MattisLind/hp9835_unified_ram_rom_board/requirements/reference_photos/connector_pin_orientation.png

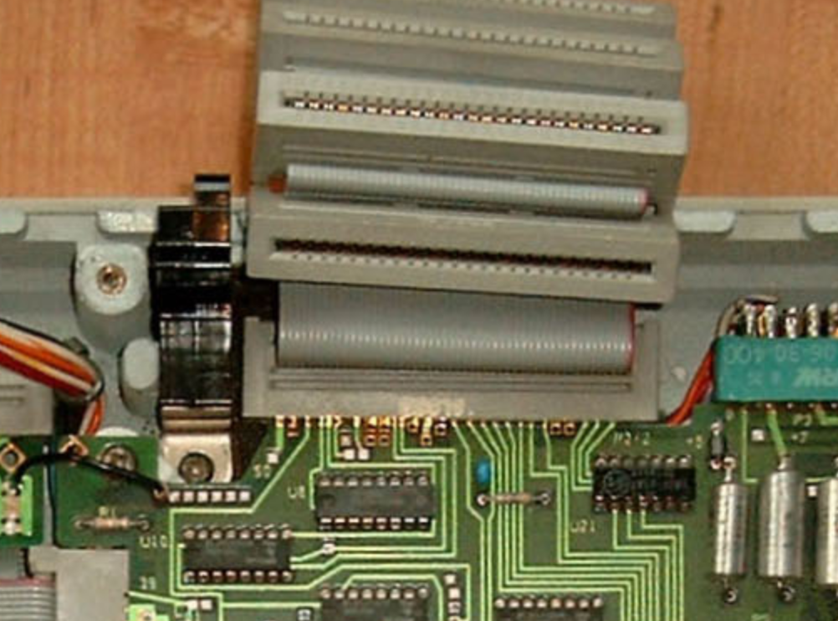
requirements/reference_photos/connector_pin_orientation.png
