MattisLind/hp9835_unified_ram_rom_board/requirements/reference_photos/connector_overview.png

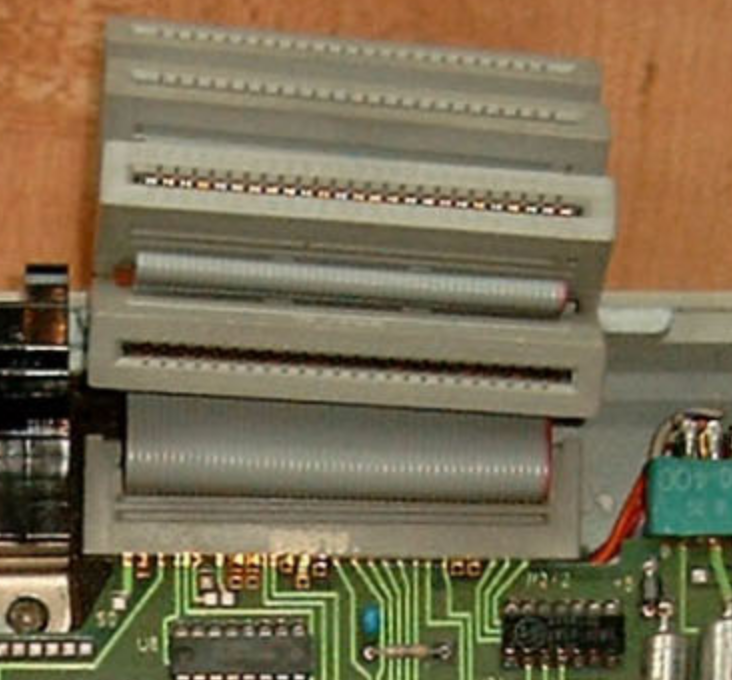
requirements/reference_photos/connector_overview.png
