MattisLind/hp9835_unified_ram_rom_board/requirements/original_archives/CornerOfOriginalSchematic/LowerRightCorner_CPU_2026-09-30_1155.pdf

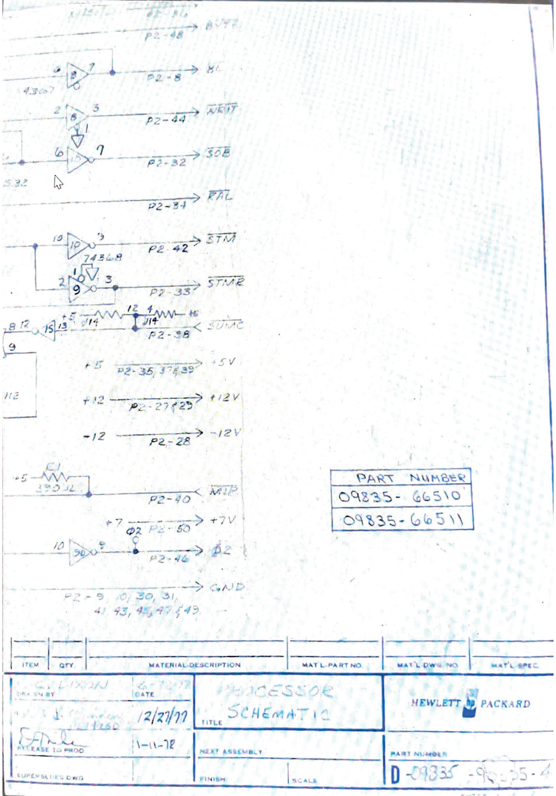
[picture p3: page 1]
