MattisLind/hp9835_unified_ram_rom_board/requirements/enhanced/HP9835_Schematics_1977_02_07/bus_original_pixels.png

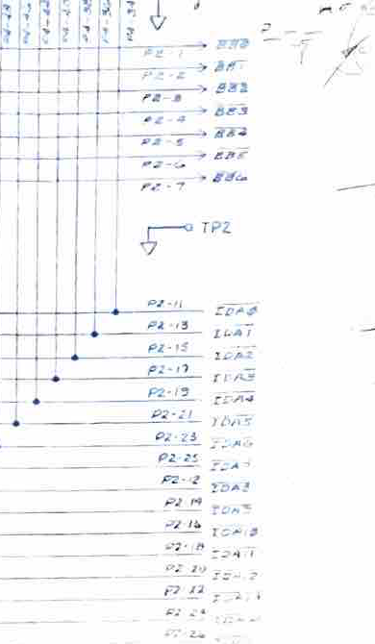
requirements/enhanced/HP9835_Schematics_1977_02_07/bus_original_pixels.png
