MattisLind/hp9835_unified_ram_rom_board/requirements/enhanced/HP9835_Schematics_1977_02_07/connector_column_red_extreme.png

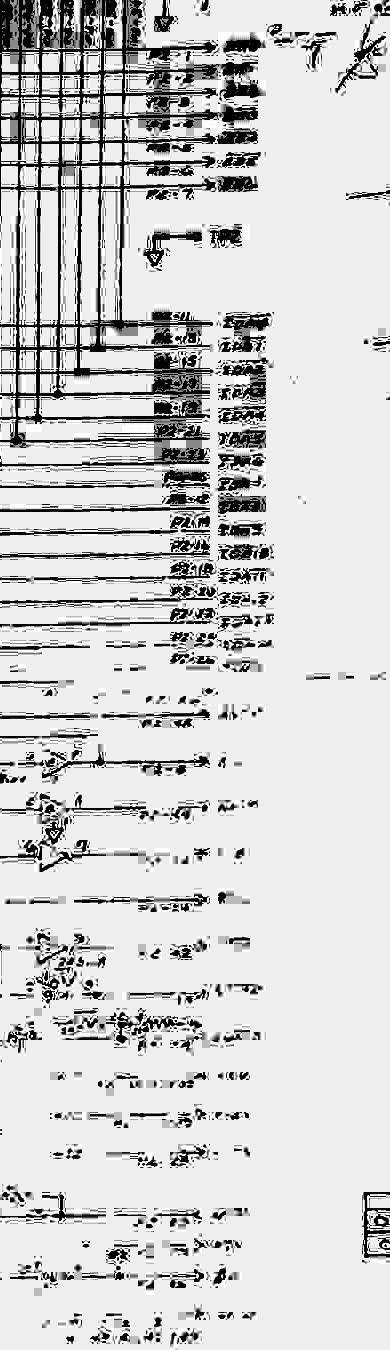
requirements/enhanced/HP9835_Schematics_1977_02_07/connector_column_red_extreme.png
