MattisLind/hp9835_unified_ram_rom_board/documentation/review_2026-09-30/actual_pin_nets.csv

reference | pin | net
C1 | 1 | GND
C1 | 2 | +5V
C2 | 1 | GND
C2 | 2 | +5V
C3 | 1 | GND
C3 | 2 | +5V
C4 | 1 | GND
C4 | 2 | +5V
C5 | 1 | GND
C5 | 2 | +5V
C6 | 1 | GND
C6 | 2 | +5V
C7 | 1 | GND
C7 | 2 | +5V
C8 | 1 | GND
C8 | 2 | +5V
J1 | 1 | unconnected-(J1-PIN1-Pad1)
J1 | 2 | unconnected-(J1-PIN2-Pad2)
J1 | 3 | unconnected-(J1-PIN3-Pad3)
J1 | 4 | HP_BYTE_N
J1 | 5 | unconnected-(J1-PIN5-Pad5)
J1 | 6 | HP_PH2
J1 | 7 | unconnected-(J1-PIN7-Pad7)
J1 | 8 | HP_WRT_N
J1 | 9 | unconnected-(J1-PIN9-Pad9)
J1 | 10 | unconnected-(J1-PIN10-Pad10)
J1 | 11 | unconnected-(J1-PIN11-Pad11)
J1 | 12 | HP_UMC_N
J1 | 13 | unconnected-(J1-PIN13-Pad13)
J1 | 14 | unconnected-(J1-PIN14-Pad14)
J1 | 15 | unconnected-(J1-PIN15-Pad15)
J1 | 16 | unconnected-(J1-PIN16-Pad16)
J1 | 17 | HP_STM_N
J1 | 18 | HP_RAL
J1 | 19 | unconnected-(J1-PIN19-Pad19)
J1 | 20 | HP_SMC
J1 | 21 | unconnected-(J1-PIN21-Pad21)
J1 | 22 | unconnected-(J1-PIN22-Pad22)
J1 | 23 | unconnected-(J1-PIN23-Pad23)
J1 | 24 | unconnected-(J1-PIN24-Pad24)
J1 | 25 | HP_IDA_N7
J1 | 26 | HP_IDA_N15
J1 | 27 | HP_IDA_N6
J1 | 28 | HP_IDA_N14
J1 | 29 | HP_IDA_N5
J1 | 30 | HP_IDA_N13
J1 | 31 | HP_IDA_N4
J1 | 32 | HP_IDA_N12
J1 | 33 | HP_IDA_N3
J1 | 34 | HP_IDA_N11
J1 | 35 | HP_IDA_N2
J1 | 36 | HP_IDA_N10
J1 | 37 | HP_IDA_N1
J1 | 38 | HP_IDA_N9
J1 | 39 | HP_IDA_N0
J1 | 40 | HP_IDA_N8
J1 | 41 | unconnected-(J1-PIN41-Pad41)
J1 | 42 | unconnected-(J1-PIN42-Pad42)
J1 | 43 | HP_BSC_N6
J1 | 44 | HP_BL_N
J1 | 45 | HP_BSC_N4
J1 | 46 | HP_BSC_N5
J1 | 47 | HP_BSC_N2
J1 | 48 | HP_BSC_N3
J1 | 49 | HP_BSC_N0
J1 | 50 | HP_BSC_N1
J2 | 1 | +5V
J2 | 2 | GND
J2 | 3 | TMS
J2 | 4 | TDI
J2 | 5 | TCK
J2 | 6 | TDO
R1 | 1 | +5V
R1 | 2 | DIP_N0
R10 | 1 | +5V
R10 | 2 | XCVR_OE_N
R11 | 1 | +5V
R11 | 2 | FLASH_CE_N
R12 | 1 | +5V
R12 | 2 | MEM_WE_N
R13 | 1 | +5V
R13 | 2 | FLASH_RESET_N
R14 | 1 | +5V
R14 | 2 | SRAM_CE_N
R16 | 1 | +5V
R16 | 2 | DIP_N9
R17 | 1 | +5V
R17 | 2 | DIP_N10
R18 | 1 | +5V
R18 | 2 | DIP_N11
R2 | 1 | +5V
R2 | 2 | DIP_N1
R3 | 1 | +5V
R3 | 2 | DIP_N2
R4 | 1 | +5V
R4 | 2 | DIP_N3
R5 | 1 | +5V
R5 | 2 | DIP_N4
R6 | 1 | +5V
R6 | 2 | DIP_N5
R7 | 1 | +5V
R7 | 2 | DIP_N6
R8 | 1 | +5V
R8 | 2 | DIP_N7
R9 | 1 | +5V
R9 | 2 | DIP_N8
SW1 | 1 | DIP_N11
SW1 | 2 | DIP_N10
SW1 | 3 | DIP_N9
SW1 | 4 | DIP_N8
SW1 | 5 | DIP_N7
SW1 | 6 | DIP_N6
SW1 | 7 | DIP_N5
SW1 | 8 | DIP_N4
SW1 | 9 | DIP_N3
SW1 | 10 | DIP_N2
SW1 | 11 | DIP_N1
SW1 | 12 | DIP_N0
SW1 | 13 | GND
SW1 | 14 | GND
SW1 | 15 | GND
SW1 | 16 | GND
SW1 | 17 | GND
SW1 | 18 | GND
SW1 | 19 | GND
SW1 | 20 | GND
SW1 | 21 | GND
SW1 | 22 | GND
SW1 | 23 | GND
SW1 | 24 | GND
U1 | 1 | FLASH_RYBY_N
U1 | 2 | SRAM_BHE_N
U1 | 3 | SRAM_BLE_N
U1 | 4 | unconnected-(U1-I/O/TDI-Pad4)
U1 | 5 | unconnected-(U1-I/O-Pad5)
U1 | 6 | SRAM_CE_N
U1 | 7 | FLASH_RESET_N
U1 | 8 | GND
U1 | 9 | MEM_WE_N
U1 | 10 | MEM_OE_N
U1 | 11 | FLASH_CE_N
U1 | 12 | +5V
U1 | 13 | GND
U1 | 14 | XCVR_DIR
U1 | 15 | XCVR_OE_N
U1 | 16 | HP_UMC_N
U1 | 17 | +5V
U1 | 18 | HP_WRT_N
U1 | 19 | HP_SMC
U1 | 20 | HP_BL_N
U1 | 21 | HP_BYTE_N
U1 | 22 | HP_BSC_N6
U1 | 23 | HP_BSC_N5
U1 | 24 | HP_BSC_N4
U1 | 25 | GND
U1 | 26 | HP_BSC_N3
U1 | 27 | HP_BSC_N2
U1 | 28 | HP_BSC_N1
U1 | 29 | HP_BSC_N0
U1 | 30 | MEM_D15
U1 | 31 | MEM_D14
U1 | 32 | MEM_D13
U1 | 33 | +5V
U1 | 34 | MEM_D12
U1 | 35 | MEM_D11
U1 | 36 | TMS
U1 | 37 | MEM_D10
U1 | 38 | MEM_D9
U1 | 39 | MEM_D8
U1 | 40 | GND
U1 | 41 | MEM_D7
U1 | 42 | MEM_D6
U1 | 43 | MEM_D5
U1 | 44 | MEM_D4
U1 | 45 | MEM_D3
U1 | 46 | MEM_D2
U1 | 47 | TDI
U1 | 48 | +5V
U1 | 49 | MEM_D1
U1 | 50 | MEM_D0
U1 | 51 | unconnected-(U1-VCCIO-Pad51)
U1 | 52 | unconnected-(U1-I/O-Pad52)
U1 | 53 | unconnected-(U1-I/O-Pad53)
U1 | 54 | unconnected-(U1-I/O-Pad54)
U1 | 55 | unconnected-(U1-I/O-Pad55)
U1 | 56 | GND
U1 | 57 | DIP_N11
U1 | 58 | DIP_N10
U1 | 59 | DIP_N9
U1 | 60 | +5V
U1 | 61 | HP_PH2
U1 | 62 | +5V
U1 | 63 | HP_RAL
U1 | 64 | ALE_CLK
U1 | 65 | unconnected-(U1-I/O-Pad65)
U1 | 66 | unconnected-(U1-VCCIO-Pad66)
U1 | 67 | MEM_A17
U1 | 68 | MEM_A16
U1 | 69 | +5V
U1 | 70 | MEM_A15
U1 | 71 | MEM_A14
U1 | 72 | MEM_A13
U1 | 73 | MEM_A12
U1 | 74 | MEM_A11
U1 | 75 | MEM_A10
U1 | 76 | MEM_A9
U1 | 77 | GND
U1 | 78 | TDO
U1 | 79 | MEM_A8
U1 | 80 | MEM_A7
U1 | 81 | MEM_A6
U1 | 82 | MEM_A5
U1 | 83 | MEM_A4
U1 | 84 | MEM_A3
U1 | 85 | +5V
U1 | 86 | MEM_A2
U1 | 87 | MEM_A1
U1 | 88 | MEM_A0
U1 | 89 | TCK
U1 | 90 | DIP_N8
U1 | 91 | DIP_N7
U1 | 92 | GND
U1 | 93 | DIP_N6
U1 | 94 | DIP_N5
U1 | 95 | DIP_N4
U1 | 96 | DIP_N3
U1 | 97 | DIP_N2
U1 | 98 | DIP_N1
U1 | 99 | DIP_N0
U1 | 100 | +5V
U2 | 1 | XCVR_OE_N
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
U6 | 2 | unconnected-(U6-1Y-Pad2)
U6 | 3 | GND
U6 | 4 | unconnected-(U6-2Y-Pad4)
U6 | 5 | GND
U6 | 6 | unconnected-(U6-3Y-Pad6)
U6 | 7 | +5V
U6 | 8 | unconnected-(U6-4Y-Pad8)
U6 | 9 | GND
U6 | 10 | unconnected-(U6-5Y-Pad10)
U6 | 11 | GND
U6 | 12 | ALE_CLK
U6 | 13 | HP_STM_N
U6 | 14 | GND
