MattisLind/hp9835_unified_ram_rom_board/documentation/review_2026-09-30/pin_plan_mismatches.csv

reference | pin | expected | actual
U1 | 1 | MEM_D0 | FLASH_RYBY_N
U1 | 2 | MEM_D1 | SRAM_BHE_N
U1 | 4 | TDI | unconnected-(U1-I/O/TDI-Pad4)
U1 | 5 | MEM_D2 | unconnected-(U1-I/O-Pad5)
U1 | 6 | MEM_D3 | SRAM_CE_N
U1 | 7 | MEM_D4 | FLASH_RESET_N
U1 | 8 | MEM_D5 | GND
U1 | 9 | MEM_D6 | MEM_WE_N
U1 | 10 | MEM_D7 | MEM_OE_N
U1 | 12 | MEM_D8 | +5V
U1 | 13 | MEM_D9 | GND
U1 | 14 | MEM_D10 | XCVR_DIR
U1 | 15 | TMS | XCVR_OE_N
U1 | 16 | MEM_D11 | HP_UMC_N
U1 | 17 | MEM_D12 | +5V
U1 | 19 | MEM_D13 | HP_SMC
U1 | 20 | MEM_D14 | HP_BL_N
U1 | 21 | MEM_D15 | HP_BYTE_N
U1 | 22 | HP_BSC_N0 | HP_BSC_N6
U1 | 23 | HP_BSC_N1 | HP_BSC_N5
U1 | 24 | HP_BSC_N2 | HP_BSC_N4
U1 | 25 | HP_BSC_N3 | GND
U1 | 27 | HP_BSC_N4 | HP_BSC_N2
U1 | 28 | HP_BSC_N5 | HP_BSC_N1
U1 | 29 | HP_BSC_N6 | HP_BSC_N0
U1 | 30 | HP_BYTE_N | MEM_D15
U1 | 31 | HP_BL_N | MEM_D14
U1 | 32 | HP_SMC | MEM_D13
U1 | 33 | HP_WRT_N | +5V
U1 | 35 | HP_UMC_N | MEM_D11
U1 | 36 | XCVR_OE_N | TMS
U1 | 37 | XCVR_DIR | MEM_D10
U1 | 40 | FLASH_CE_N | GND
U1 | 41 | MEM_OE_N | MEM_D7
U1 | 42 | MEM_WE_N | MEM_D6
U1 | 44 | FLASH_RESET_N | MEM_D4
U1 | 45 | SRAM_CE_N | MEM_D3
U1 | 48 | SRAM_BLE_N | +5V
U1 | 49 | SRAM_BHE_N | MEM_D1
U1 | 50 | FLASH_RYBY_N | MEM_D0
U1 | 52 | DIP_N0 | unconnected-(U1-I/O-Pad52)
U1 | 53 | DIP_N1 | unconnected-(U1-I/O-Pad53)
U1 | 54 | DIP_N2 | unconnected-(U1-I/O-Pad54)
U1 | 55 | DIP_N3 | unconnected-(U1-I/O-Pad55)
U1 | 56 | DIP_N4 | GND
U1 | 57 | DIP_N5 | DIP_N11
U1 | 58 | DIP_N6 | DIP_N10
U1 | 60 | DIP_N7 | +5V
U1 | 61 | DIP_N8 | HP_PH2
U1 | 62 | TCK | +5V
U1 | 63 | MEM_A0 | HP_RAL
U1 | 64 | MEM_A1 | ALE_CLK
U1 | 65 | MEM_A2 | unconnected-(U1-I/O-Pad65)
U1 | 67 | MEM_A3 | MEM_A17
U1 | 68 | MEM_A4 | MEM_A16
U1 | 69 | MEM_A5 | +5V
U1 | 70 | MEM_A6 | MEM_A15
U1 | 71 | MEM_A7 | MEM_A14
U1 | 72 | MEM_A8 | MEM_A13
U1 | 73 | TDO | MEM_A12
U1 | 75 | MEM_A9 | MEM_A10
U1 | 76 | MEM_A10 | MEM_A9
U1 | 77 | MEM_A11 | GND
U1 | 78 | MEM_A12 | TDO
U1 | 79 | MEM_A13 | MEM_A8
U1 | 80 | MEM_A14 | MEM_A7
U1 | 81 | MEM_A15 | MEM_A6
U1 | 83 | MEM_A16 | MEM_A4
U1 | 84 | MEM_A17 | MEM_A3
U1 | 87 | ALE_CLK | MEM_A1
U1 | 88 | HP_RAL | MEM_A0
U1 | 89 | GCLR_N | TCK
U1 | 90 | HP_PH2 | DIP_N8
U1 | 92 | DIP_N9 | GND
U1 | 93 | DIP_N10 | DIP_N6
U1 | 94 | DIP_N11 | DIP_N5
J1 | 1 | HP_BSC_N0 | unconnected-(J1-PIN1-Pad1)
J1 | 2 | HP_BSC_N1 | unconnected-(J1-PIN2-Pad2)
J1 | 3 | HP_BSC_N2 | unconnected-(J1-PIN3-Pad3)
J1 | 4 | HP_BSC_N3 | HP_BYTE_N
J1 | 5 | HP_BSC_N4 | unconnected-(J1-PIN5-Pad5)
J1 | 6 | HP_BSC_N5 | HP_PH2
J1 | 7 | HP_BSC_N6 | unconnected-(J1-PIN7-Pad7)
J1 | 8 | HP_BL_N | HP_WRT_N
J1 | 11 | HP_IDA_N0 | unconnected-(J1-PIN11-Pad11)
J1 | 12 | HP_IDA_N8 | HP_UMC_N
J1 | 13 | HP_IDA_N1 | unconnected-(J1-PIN13-Pad13)
J1 | 14 | HP_IDA_N9 | unconnected-(J1-PIN14-Pad14)
J1 | 15 | HP_IDA_N2 | unconnected-(J1-PIN15-Pad15)
J1 | 16 | HP_IDA_N10 | unconnected-(J1-PIN16-Pad16)
J1 | 17 | HP_IDA_N3 | HP_STM_N
J1 | 18 | HP_IDA_N11 | HP_RAL
J1 | 19 | HP_IDA_N4 | unconnected-(J1-PIN19-Pad19)
J1 | 20 | HP_IDA_N12 | HP_SMC
J1 | 21 | HP_IDA_N5 | unconnected-(J1-PIN21-Pad21)
J1 | 22 | HP_IDA_N13 | unconnected-(J1-PIN22-Pad22)
J1 | 23 | HP_IDA_N6 | unconnected-(J1-PIN23-Pad23)
J1 | 24 | HP_IDA_N14 | unconnected-(J1-PIN24-Pad24)
J1 | 32 | HP_SMC | HP_IDA_N12
J1 | 33 | HP_STM_N | HP_IDA_N3
J1 | 34 | HP_RAL | HP_IDA_N11
J1 | 40 | HP_UMC_N | HP_IDA_N8
J1 | 44 | HP_WRT_N | HP_BL_N
J1 | 46 | HP_PH2 | HP_BSC_N5
J1 | 48 | HP_BYTE_N | HP_BSC_N3
