MattisLind/hp9835_unified_ram_rom_board/documentation/hp9835_unified_ram_rom_board_revG.pdf

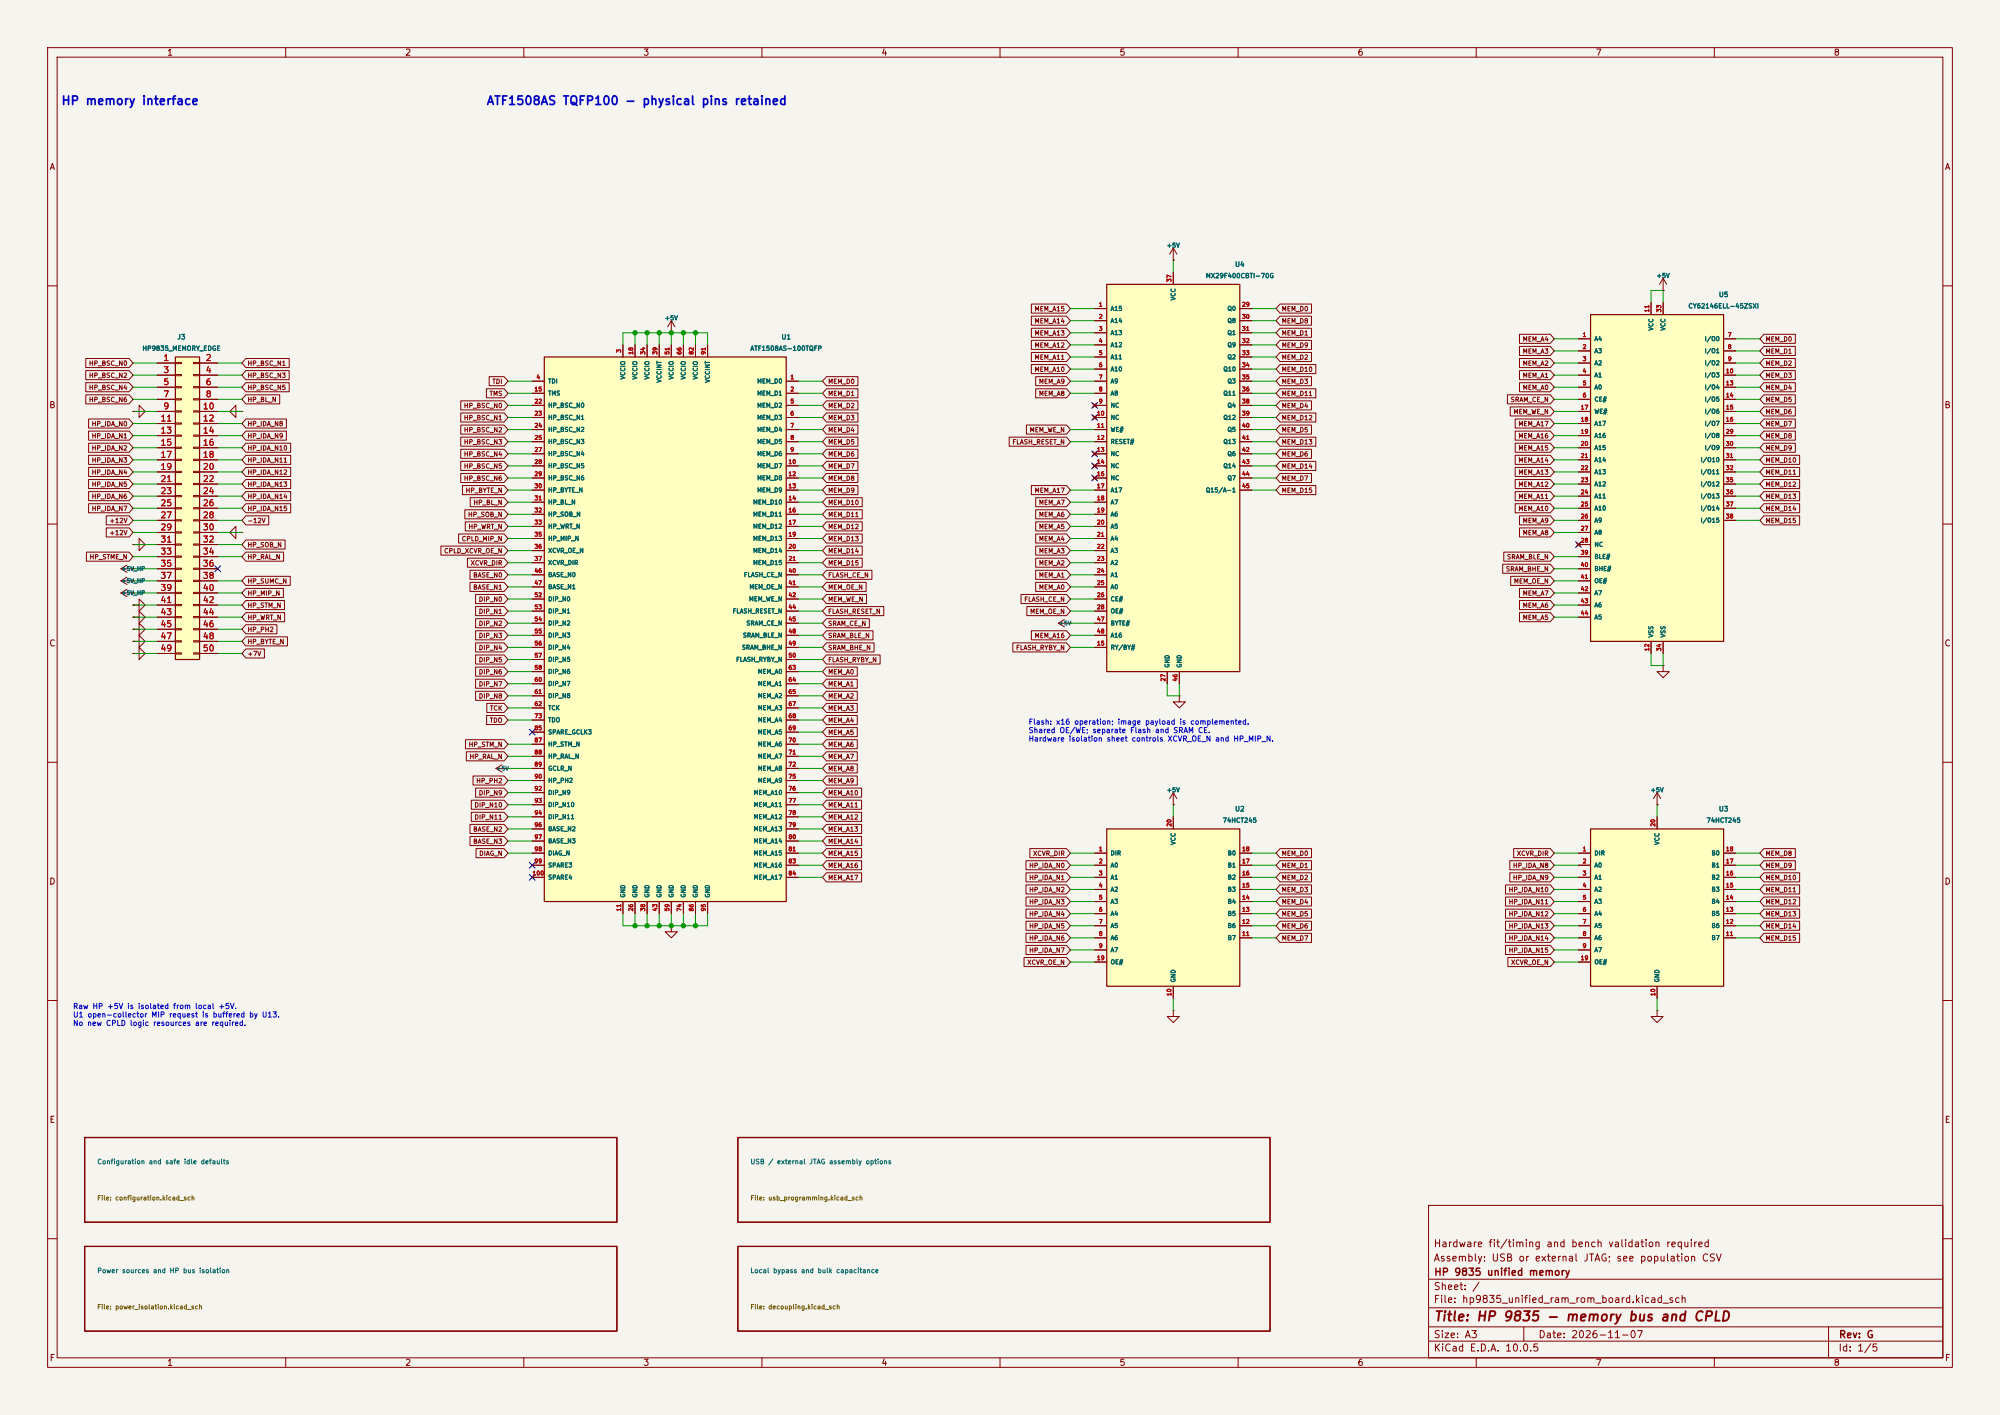
[picture p22: page 1]

File: decoupling.kicad_sch Configuration and safe idle defaults File: configuration.kicad_sch Power sources and HP bus isolation

Hardware fit/timing and bench validation required
Assembly: USB or external JTAG; see population CSV
HP 9835 unified memory
Sheet: /
File: hp9835_unified_ram_rom_board.kicad_sch
Title: HP 9835 - memory bus and CPLD

Local bypass and bulk capacitance

Size: A3 | Rev: G | F Date: 2026-11-07
KiCad E.D.A. 10.0.5 | Id: 1/5

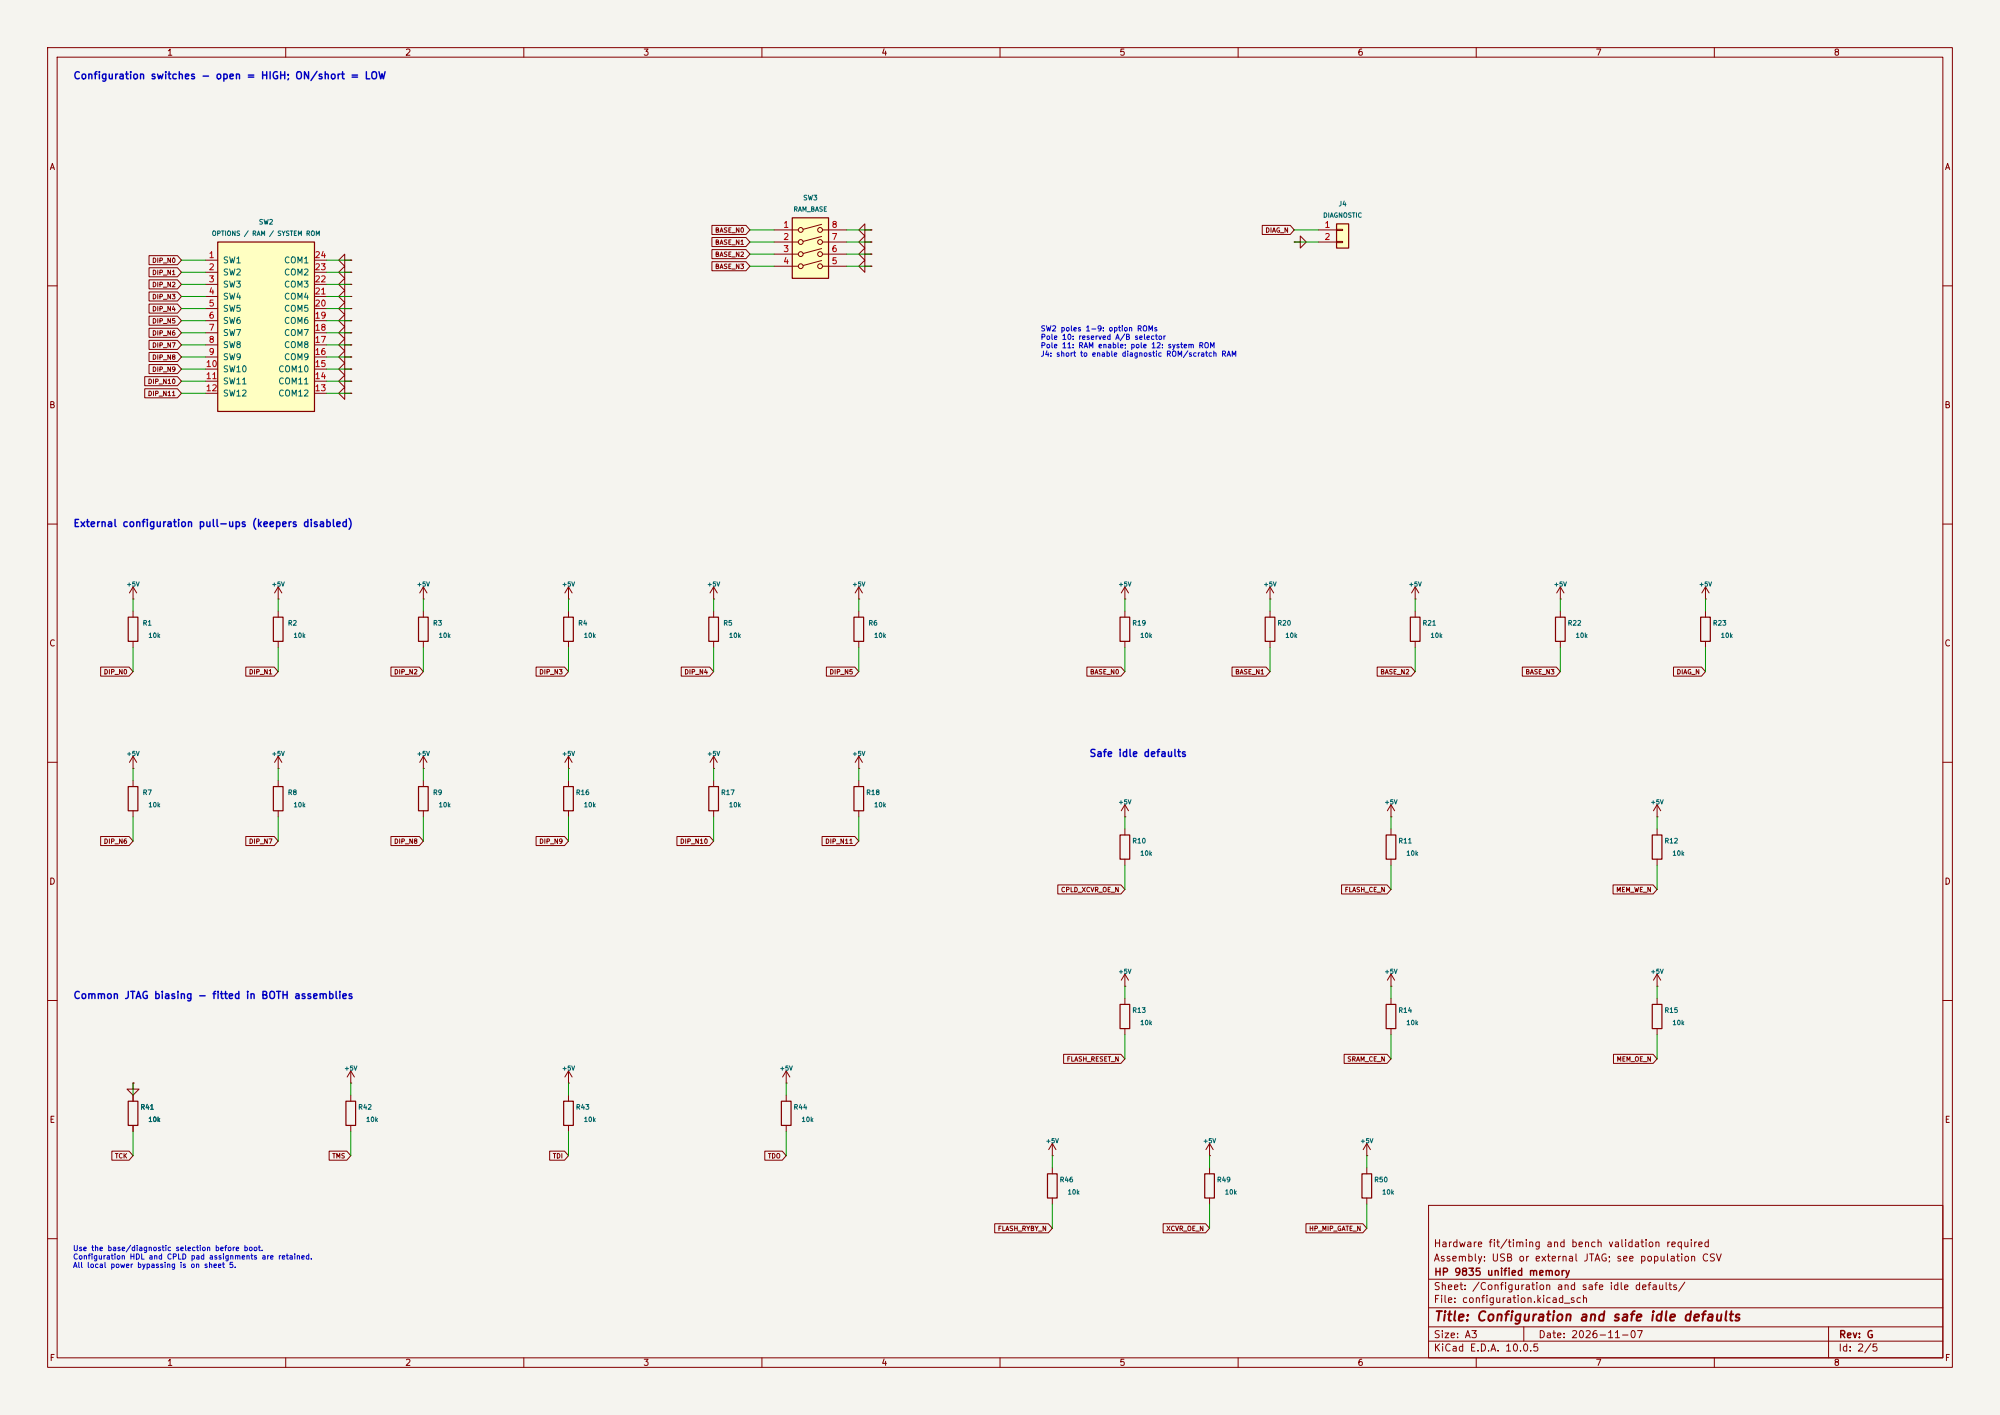
[picture p23: page 2]

Configuration switches - open = HIGH; ON/short = LOW

SW2 OPTIONS / RAM / SYSTEM ROM

SW2 poles 1-9: option ROMs Pole 10: reserved A/B selector Pole 11: RAM enable; pole 12: system ROM

J4: short to enable diagnostic ROM/scratch RAM External configuration pull-ups (keepers disabled)

Use the base/diagnostic selection before boot. Configuration HDL and CPLD pad assignments are retained. All local power bypassing is on sheet 5. Common JTAG biasing - fitted in BOTH assemblies

Hardware fit/timing and bench validation required
Assembly: USB or external JTAG; see population CSV
HP 9835 unified memory
Sheet: /Configuration and safe idle defaults/
File: configuration.kicad_sch
Title: Configuration and safe idle defaults

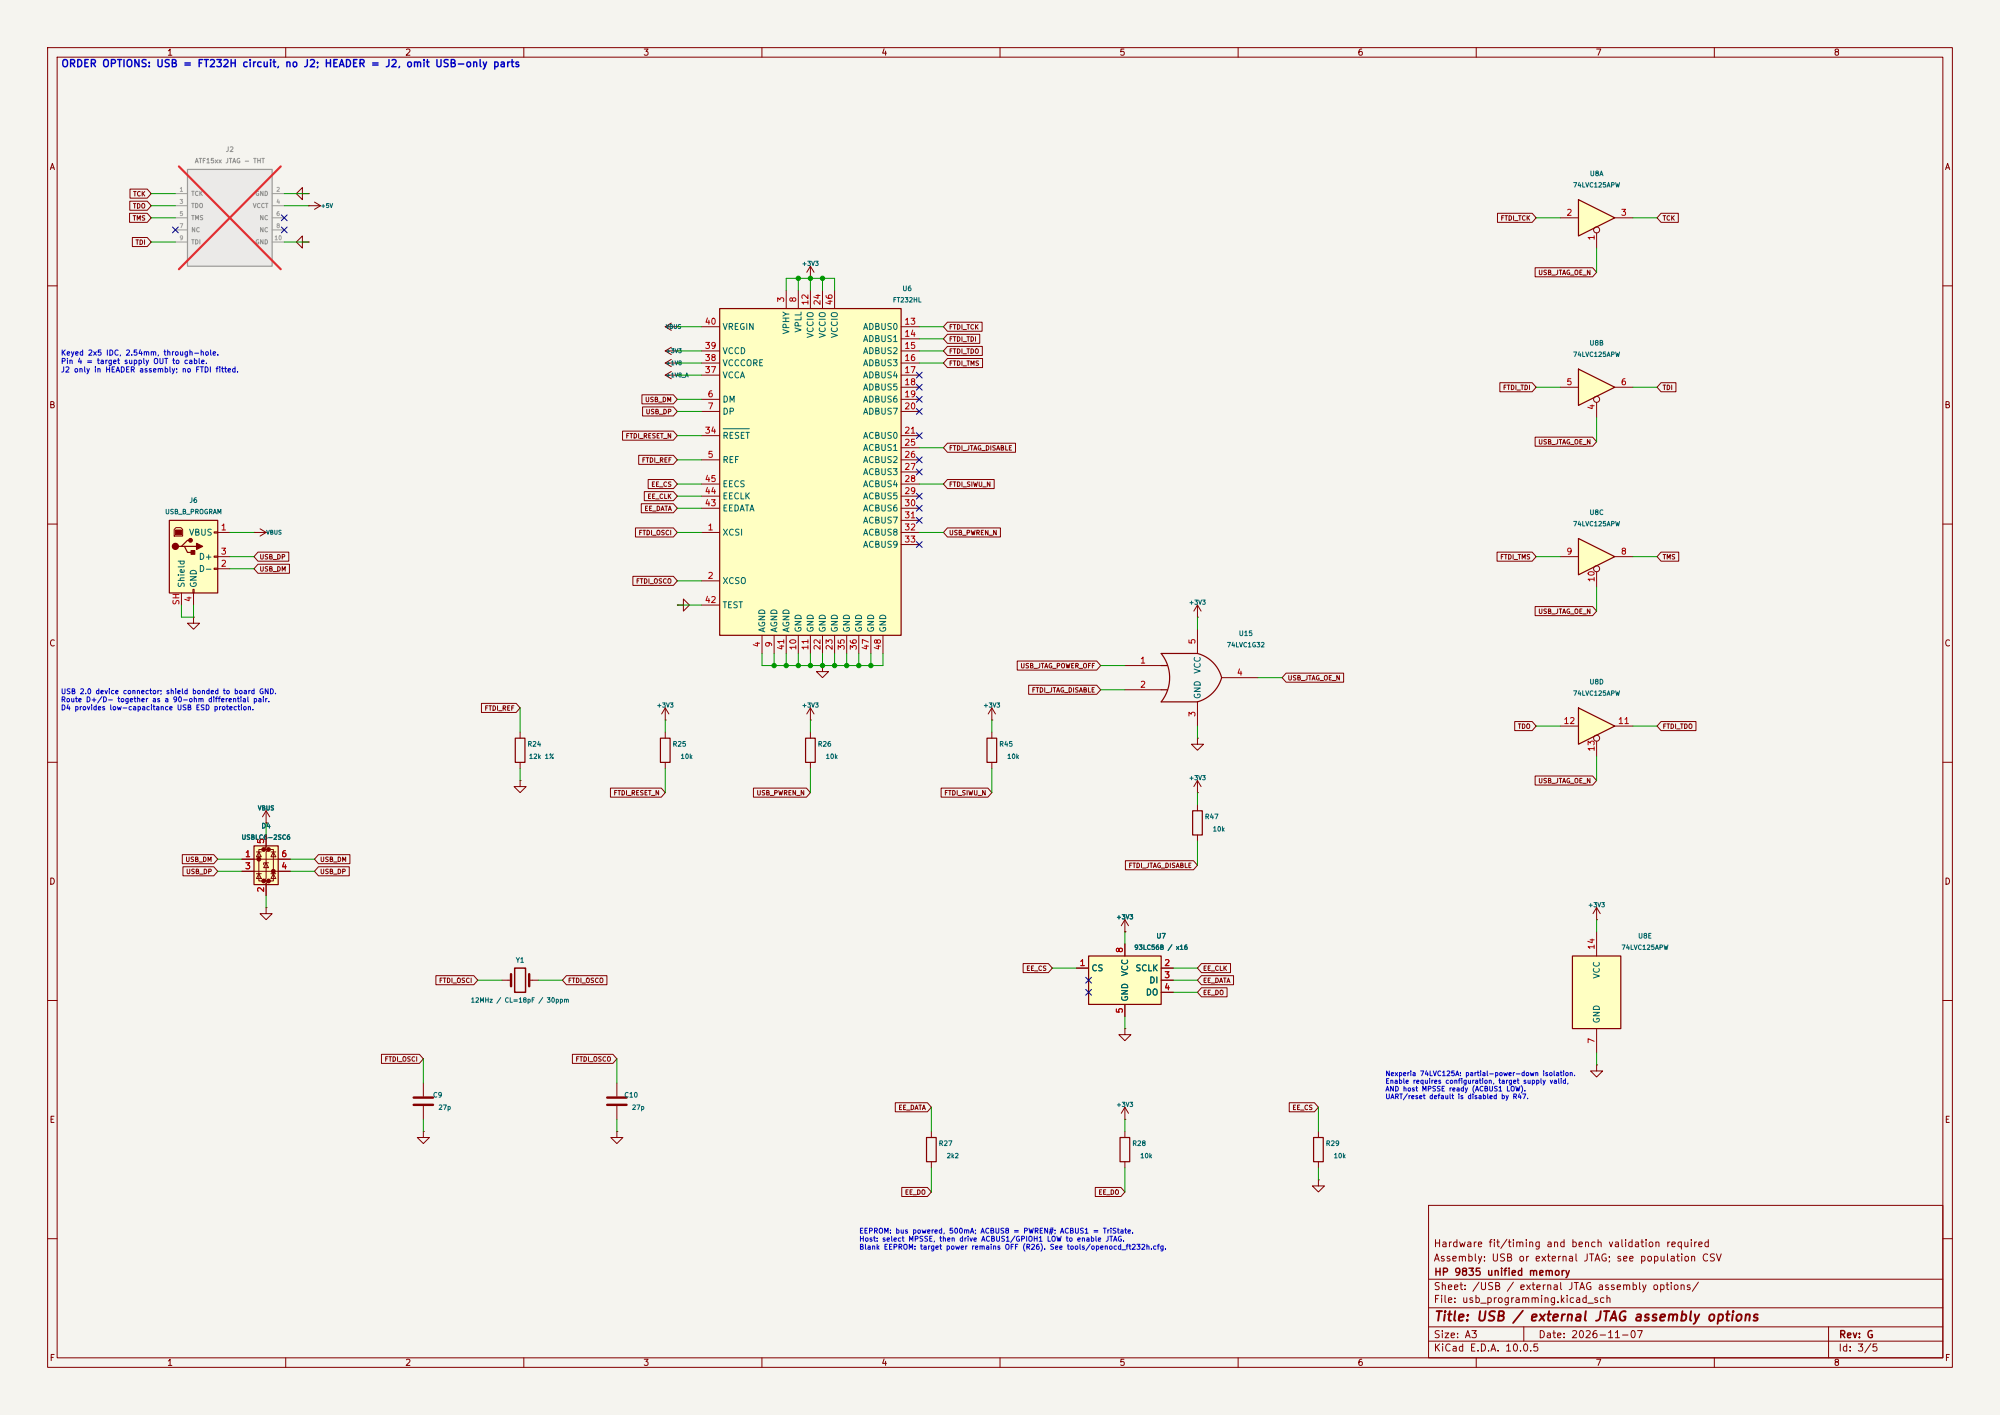
[picture p24: page 3]

TCK USB 2.0 device connector; shield bonded to board GND. Route D+/D- together as a 90-ohm differential pair. D4 provides low-capacitance USB ESD protection. Keyed 2x5 IDC, 2.54mm, through-hole. Pin 4 = target supply OUT to cable. J2 only in HEADER assembly; no FTDI fitted. ORDER OPTIONS: USB = FT232H circuit, no J2; HEADER = J2, omit USB-only parts

4 REF 5 DM 6 DP 7 VPLL 8 AGND

Hardware fit/timing and bench validation required
Assembly: USB or external JTAG; see population CSV
HP 9835 unified memory
Sheet: /USB / external JTAG assembly options/
File: usb_programming.kicad_sch
Title: USB / external JTAG assembly options

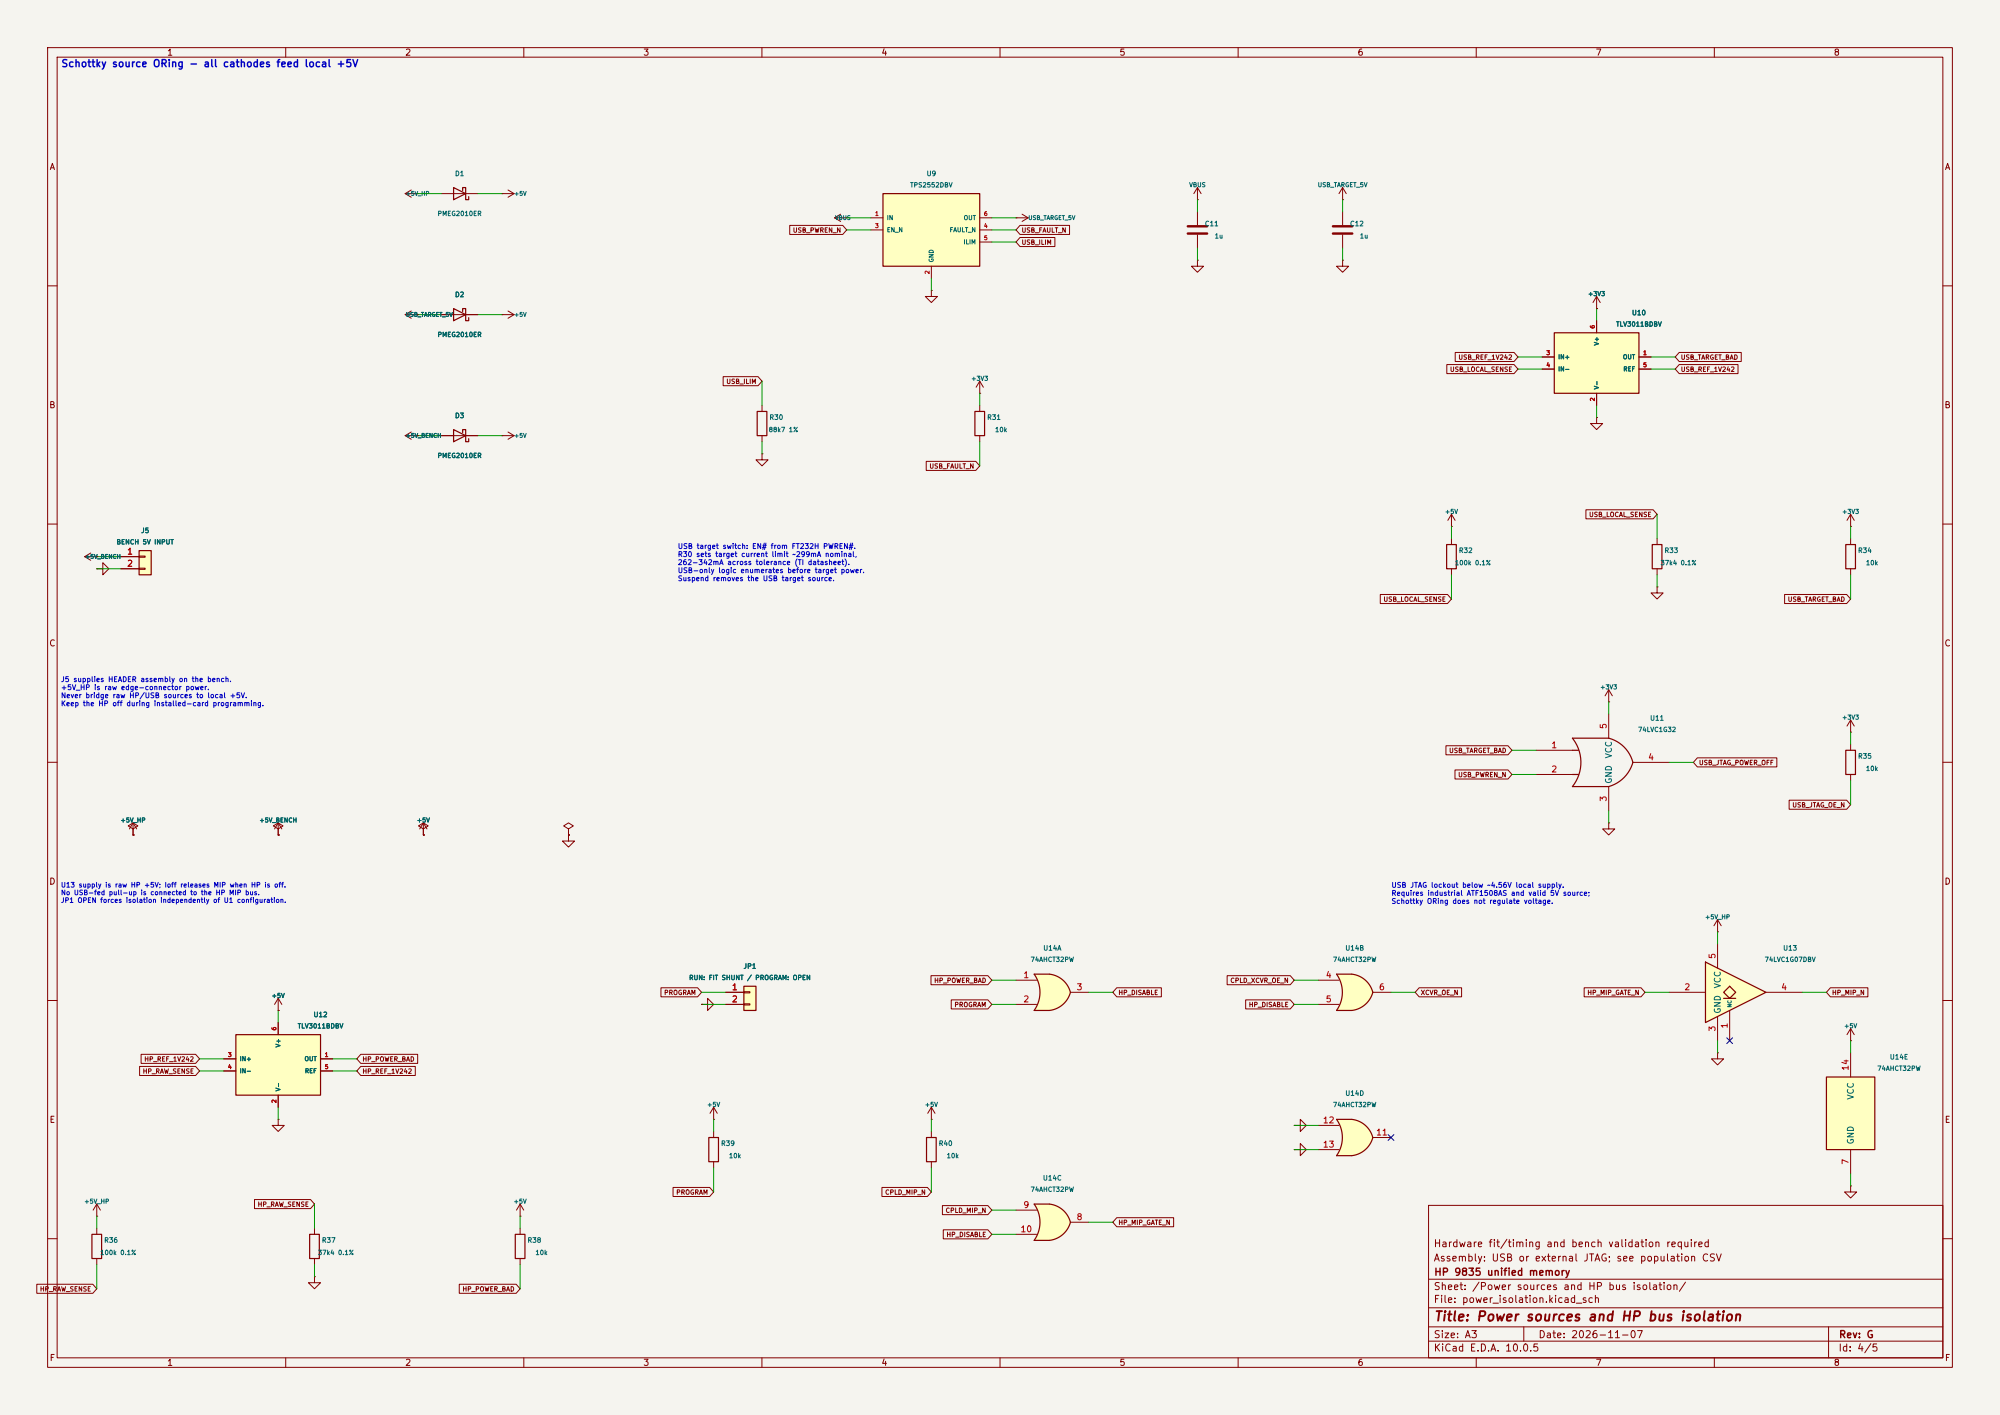
[picture p25: page 4]

RUN: FIT SHUNT / PROGRAM: OPEN 1

Hardware fit/timing and bench validation required
Assembly: USB or external JTAG; see population CSV
HP 9835 unified memory
Sheet: /Power sources and HP bus isolation/
File: power_isolation.kicad_sch
Title: Power sources and HP bus isolation

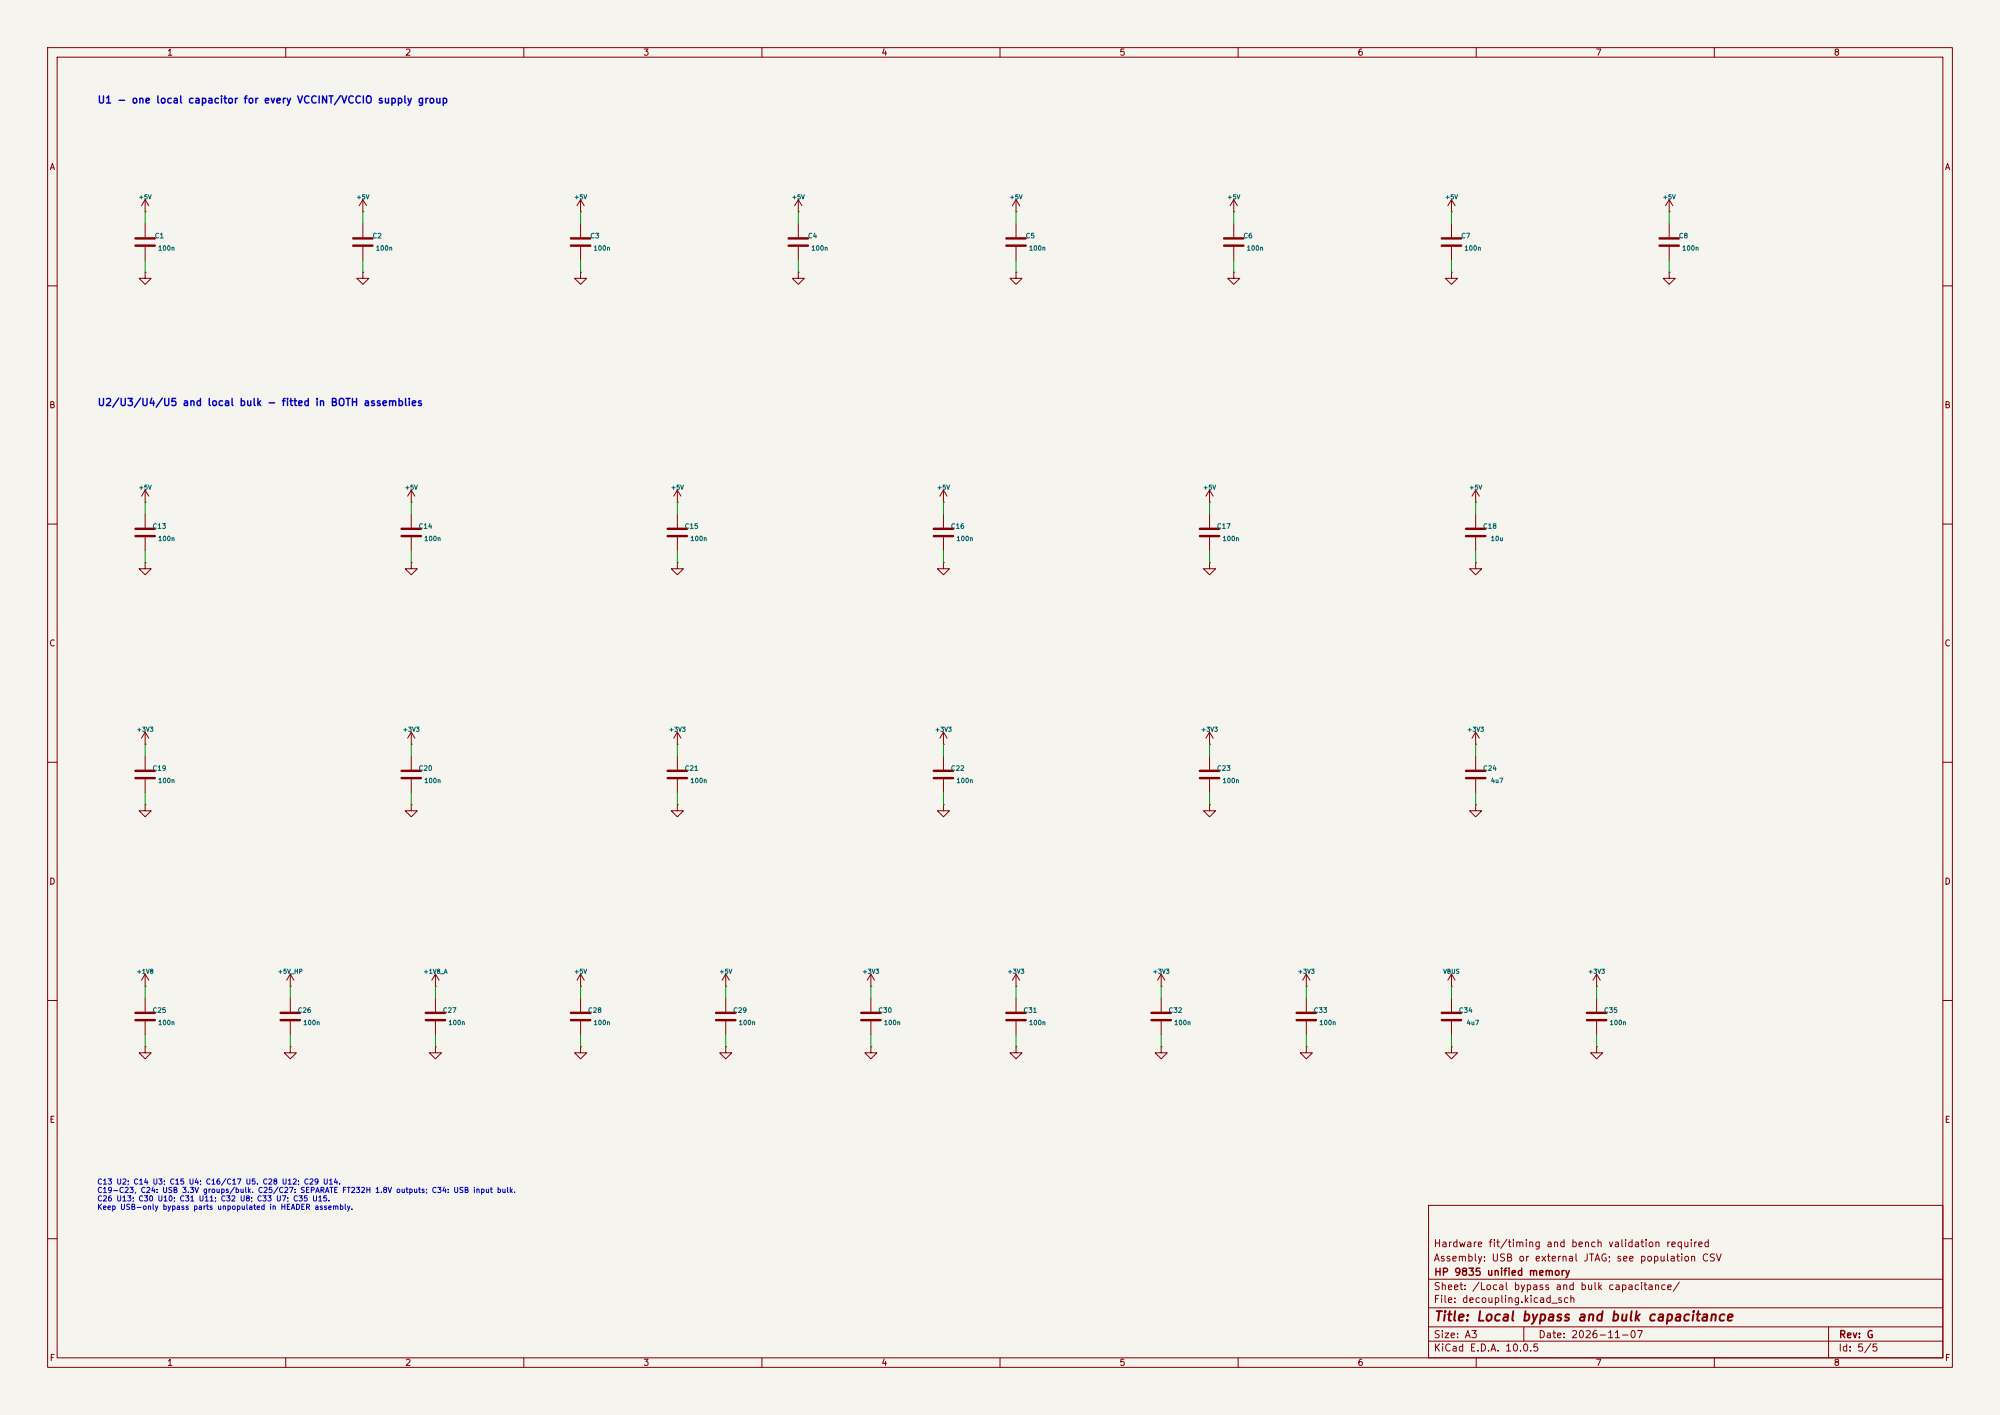
[picture p26: page 5]

U1 - one local capacitor for every VCCINT/VCCIO supply group

U2/U3/U4/U5 and local bulk - fitted in BOTH assemblies

C13 U2; C14 U3; C15 U4; C16/C17 U5. C28 U12; C29 U14. C19-C23, C24: USB 3.3V groups/bulk. C25/C27: SEPARATE FT232H 1.8V outputs; C34: USB input bulk. C26 U13; C30 U10; C31 U11; C32 U8; C33 U7; C35 U15. Keep USB-only bypass parts unpopulated in HEADER assembly.

Hardware fit/timing and bench validation required
Assembly: USB or external JTAG; see population CSV
HP 9835 unified memory
Sheet: /Local bypass and bulk capacitance/
File: decoupling.kicad_sch
Title: Local bypass and bulk capacitance
