MattisLind/hp9835_unified_ram_rom_board/requirements/extracted/9835_ROMCard/9835_ROM_Diagram.pdf

# Latch 1 ALE 123645

1A1

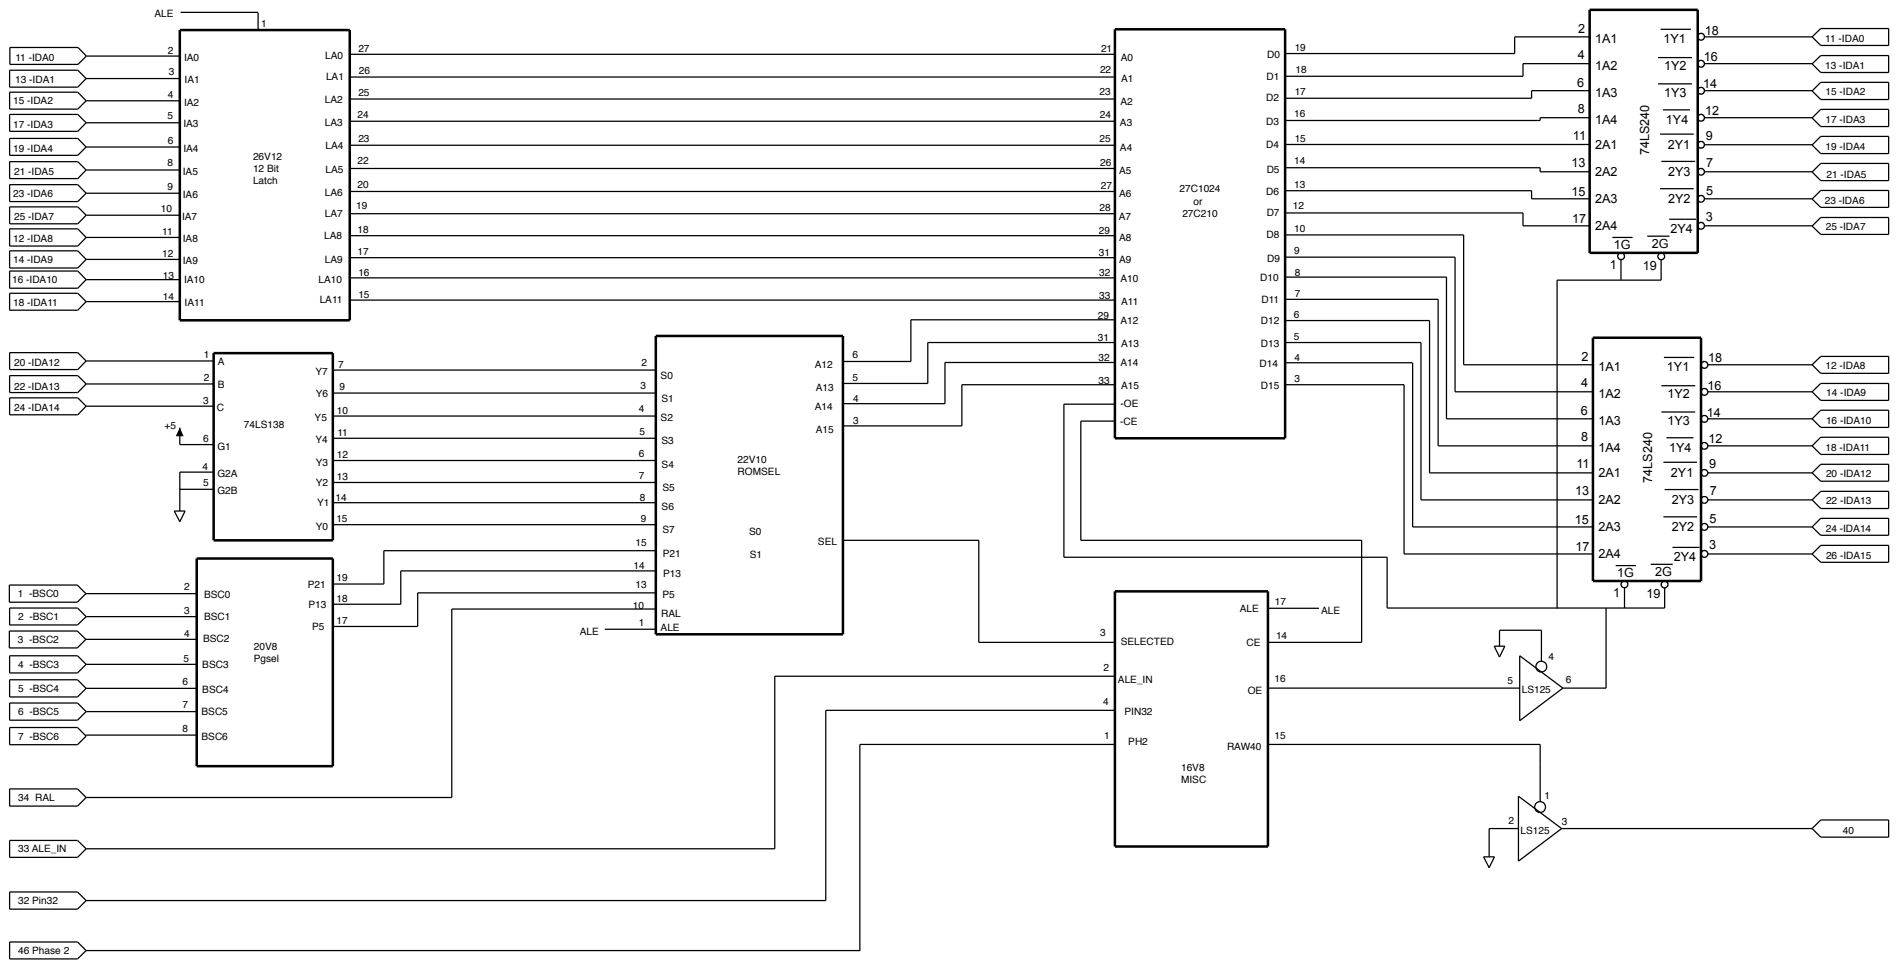
[picture p27: page 1]
