MattisLind/hp9835_unified_ram_rom_board/requirements/extracted/DiagROM_Single_Card/DiagRAMROM.pdf

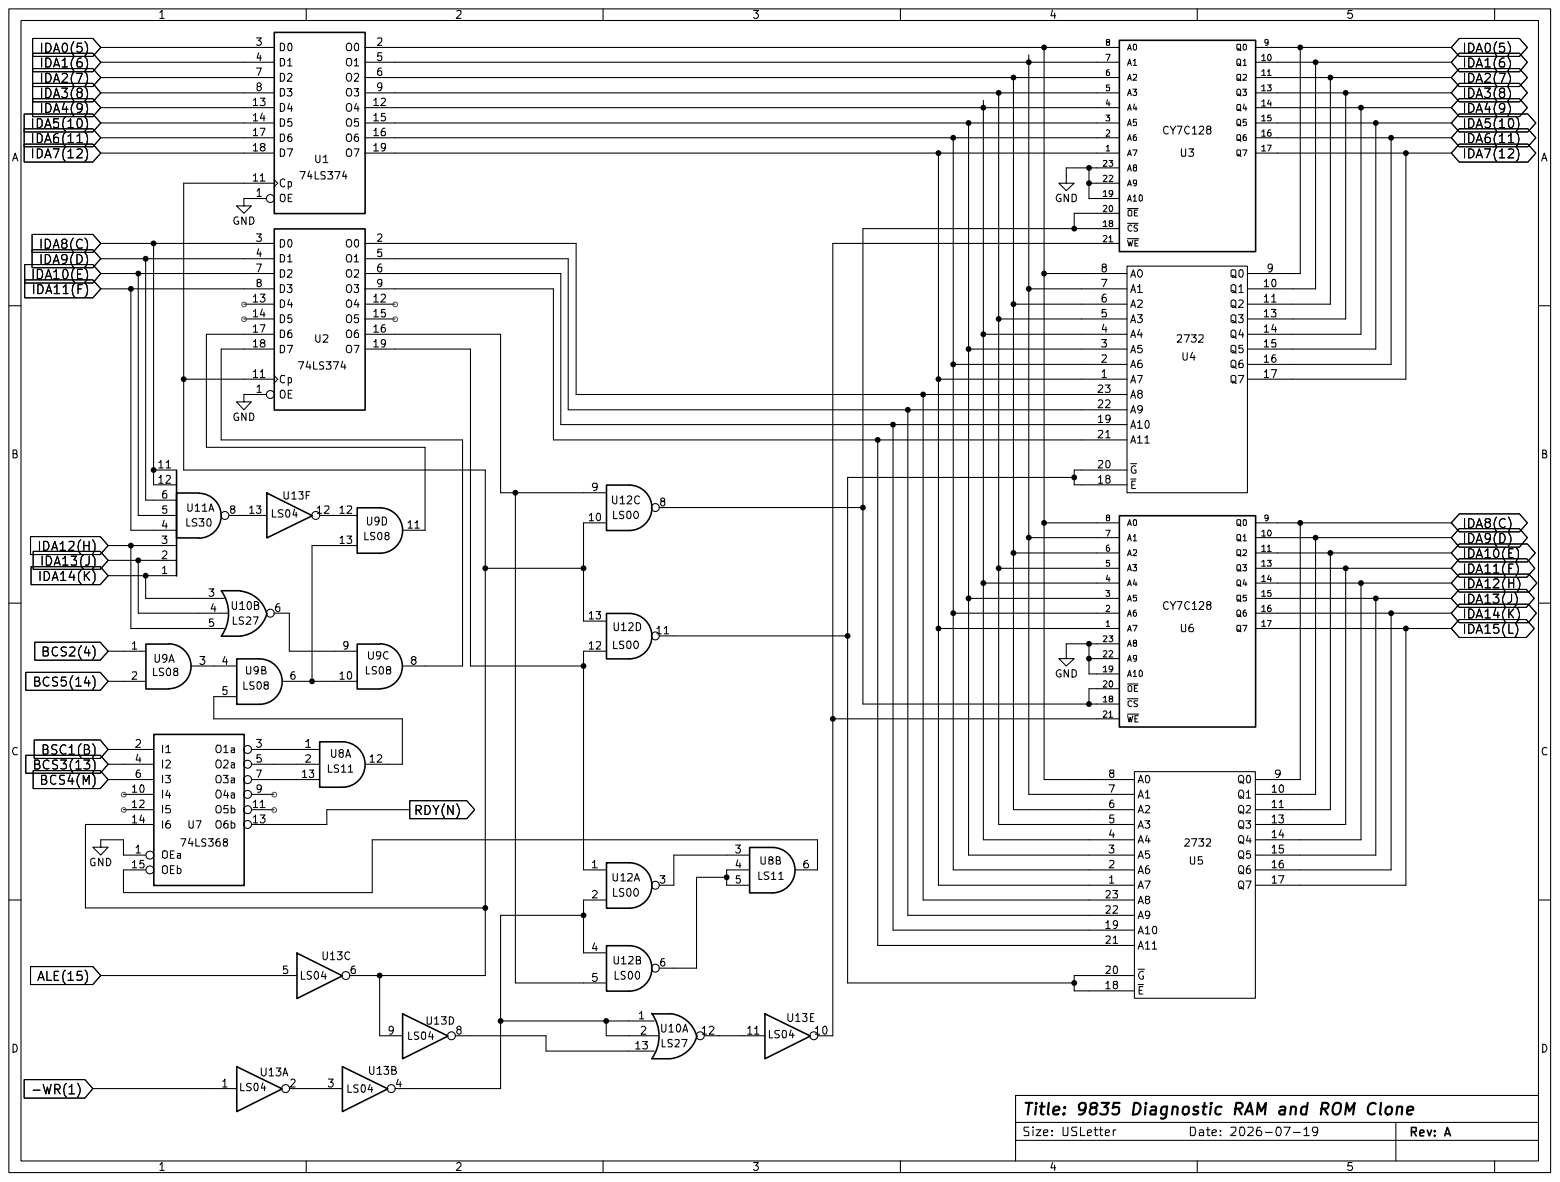
[picture p28: page 1]
