MattisLind/hp9835_unified_ram_rom_board/requirements/extracted/RAM_Card/RAM_Schematic.pdf

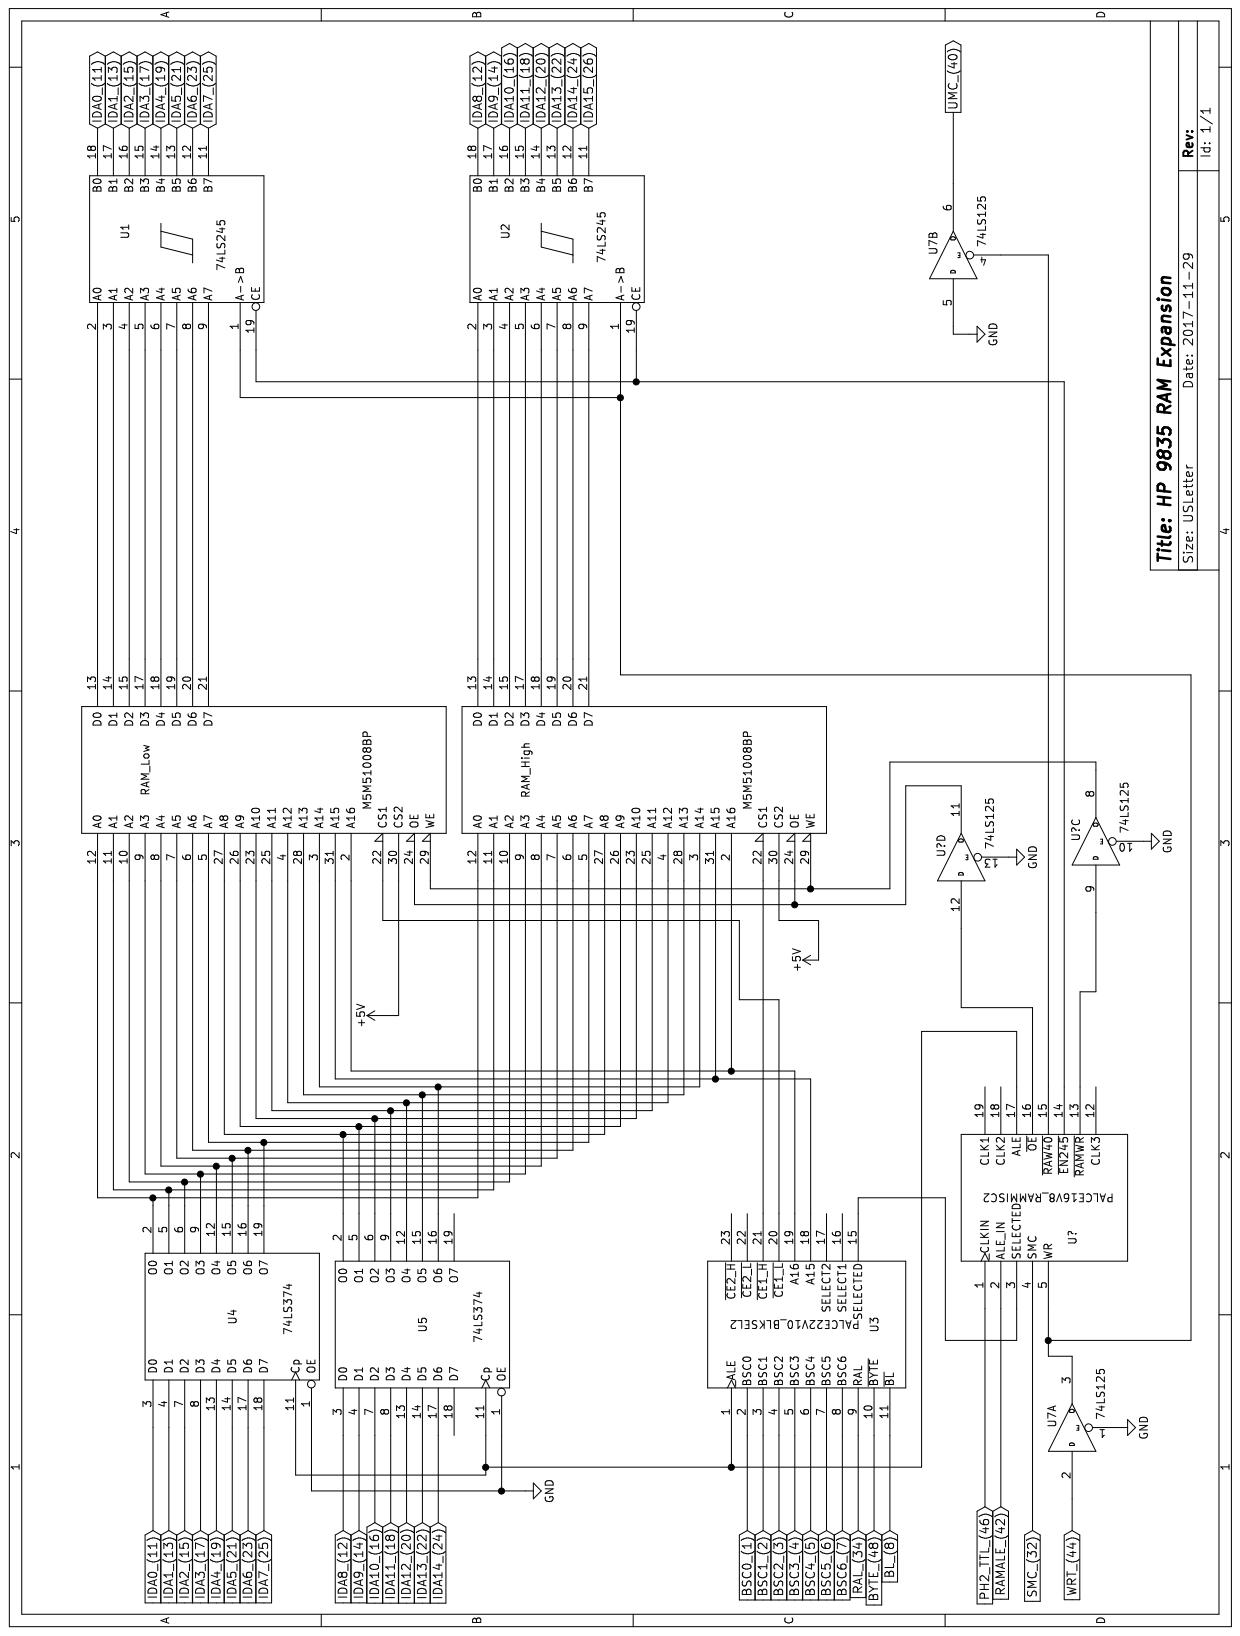
[picture p29: page 1]
