MattisLind/hp9835_unified_ram_rom_board/kicad/hp9835_unified_ram_rom_board/configuration.kicad_sch

## KiCad design kicad/hp9835_unified_ram_rom_board/configuration.kicad_sch (2026-11-07)

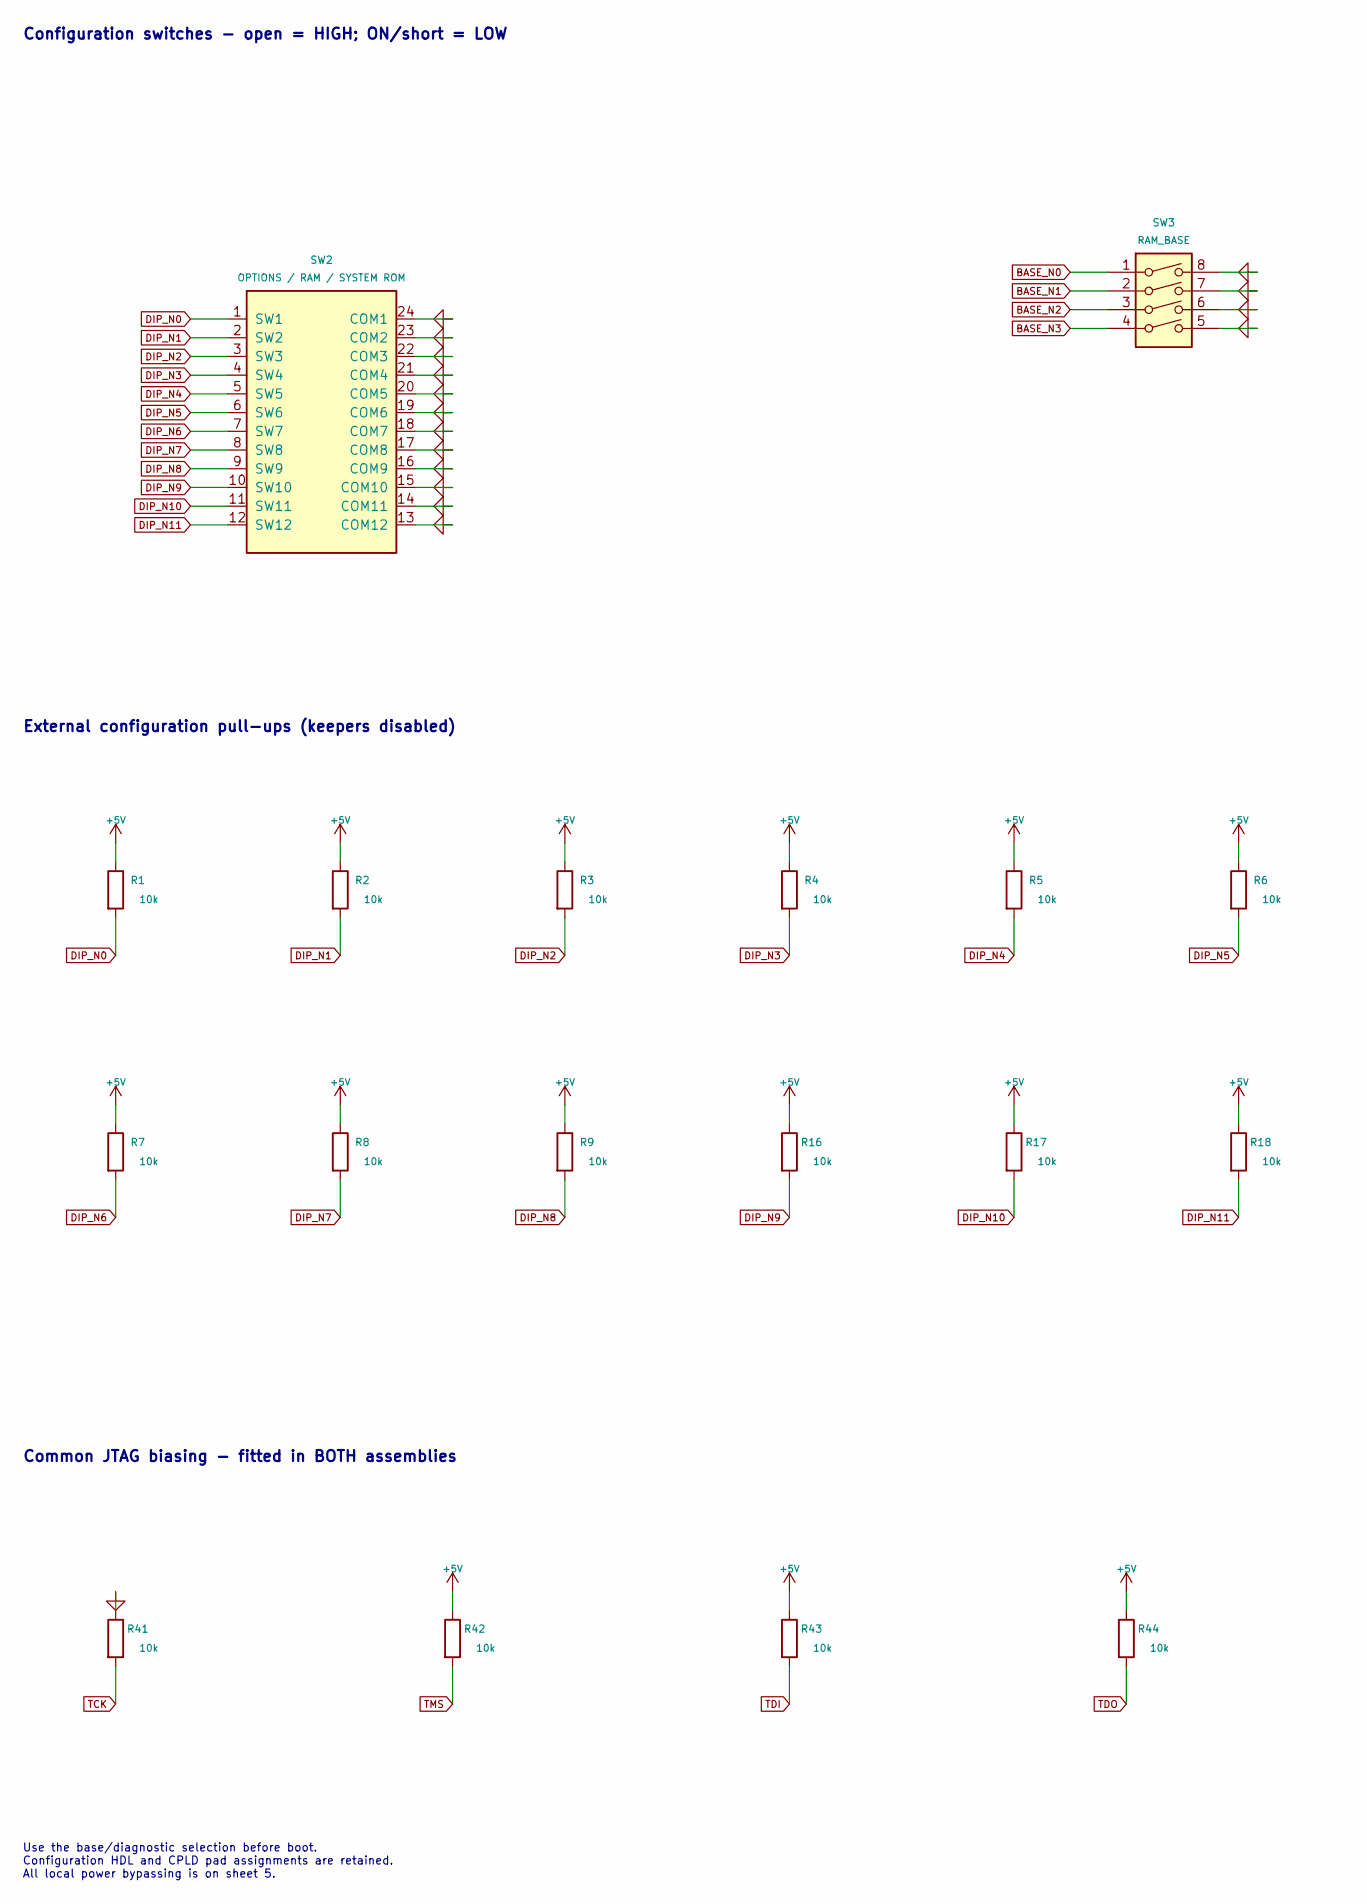
[picture p30: schematic configuration.kicad_sch, part in row 1, column 1]

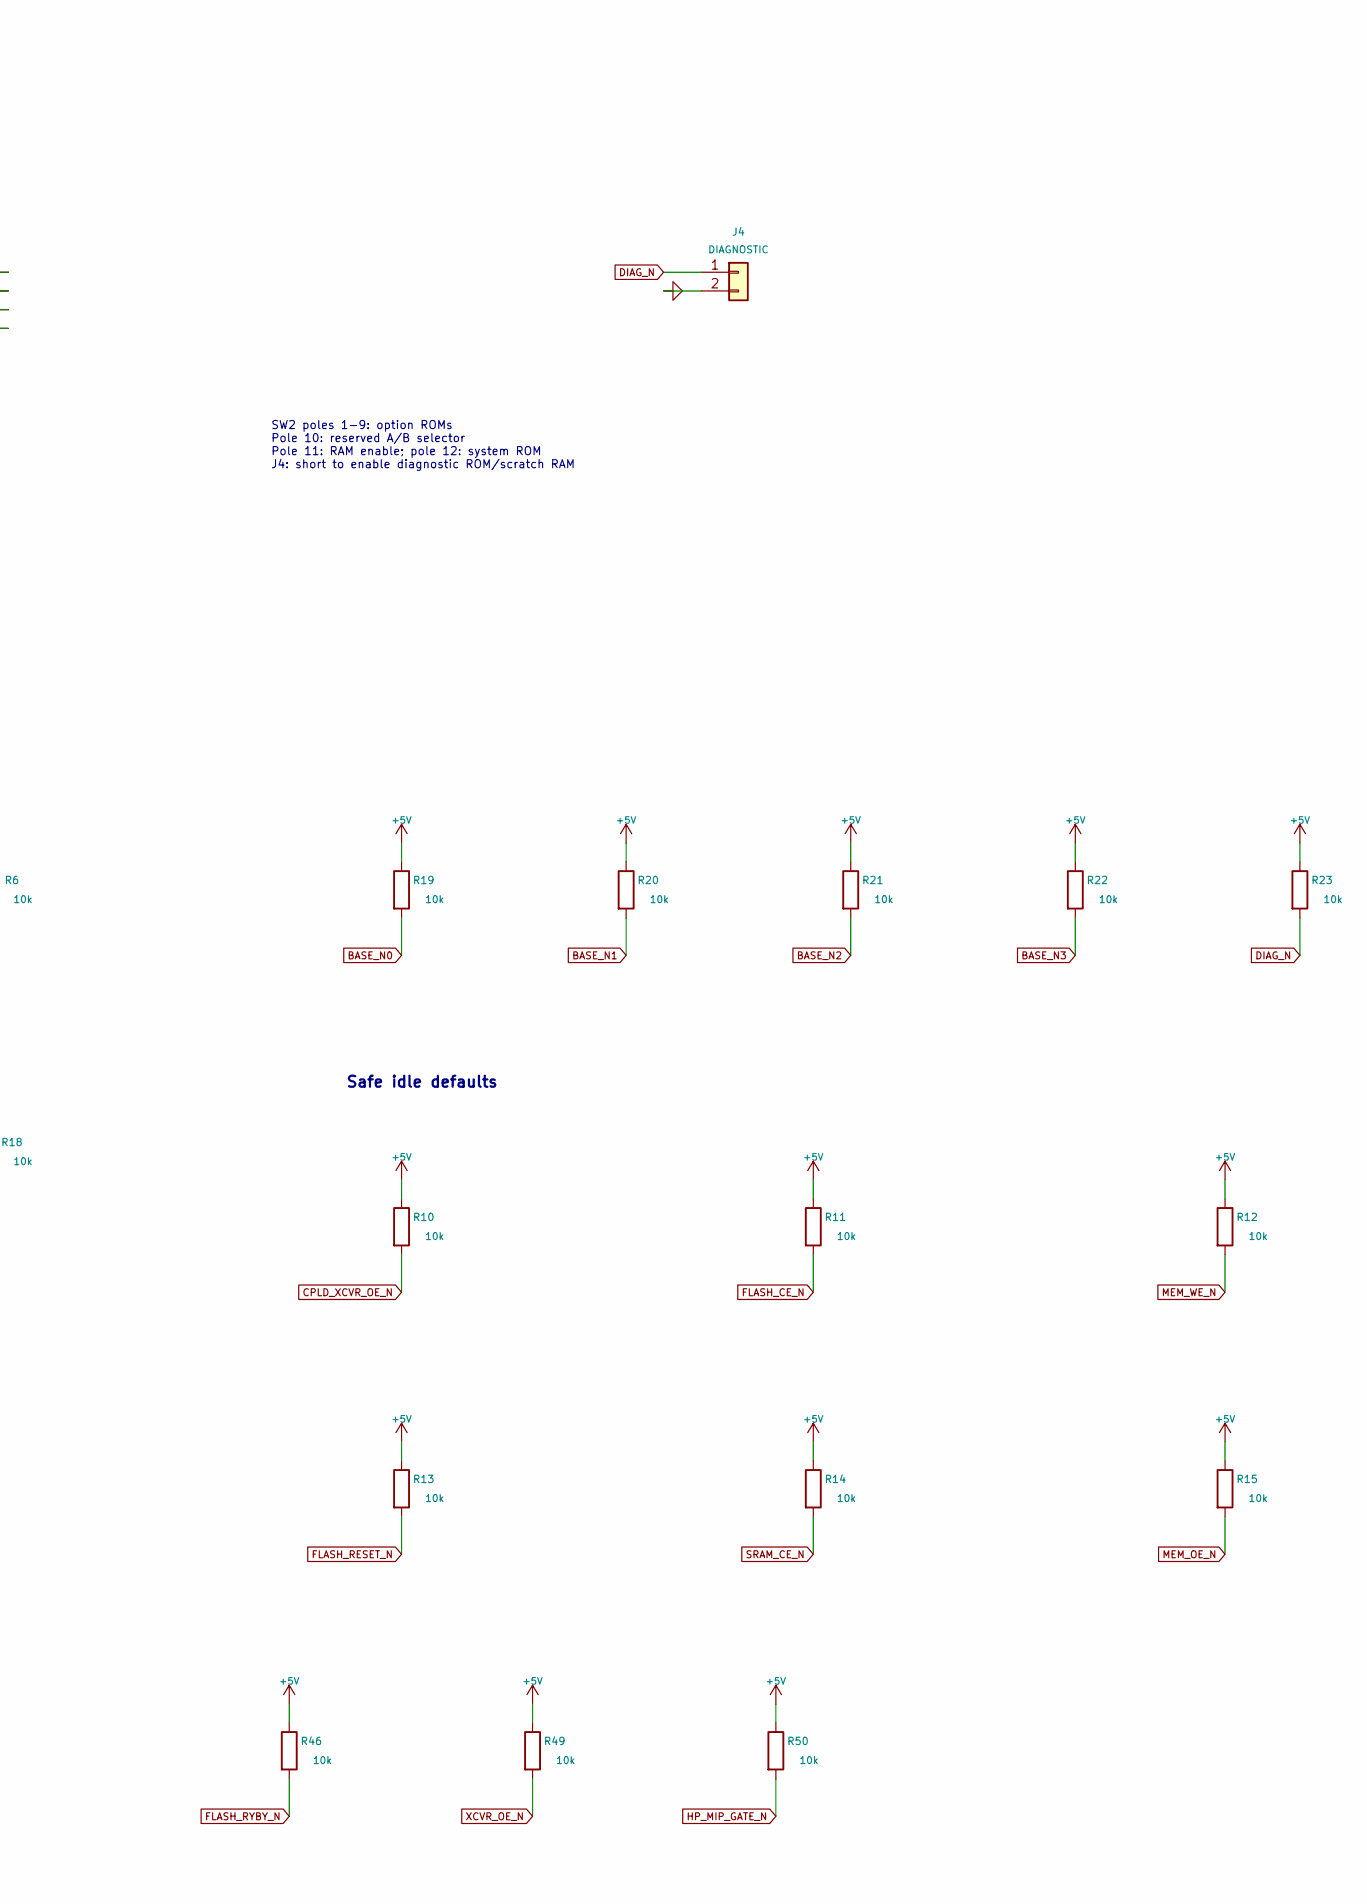
[picture p31: schematic configuration.kicad_sch, part in row 1, column 2]

Parts:
J4: DIAGNOSTIC; PinHeader_1x02_P2.54mm_Vertical
R1, R2, R3, R4, R5, R6, R7, R8, R9, R10, R11, R12, R13, R14, R15, R16, R17, R18, R19, R20, R21, R22, R23, R41, R42, R43, R44, R46, R49, R50: 10k; R_0805_2012Metric
SW2: OPTIONS / RAM / SYSTEM ROM; SW_DIP_SPSTx12_Slide_9.78x32.66mm_W7.62mm_P2.54mm
SW3: RAM_BASE; SW_DIP_SPSTx04_Slide_9.78x12.34mm_W7.62mm_P2.54mm

Connections:
+5V: R1.1, R2.1, R3.1, R4.1, R5.1, R6.1, R7.1, R8.1, R9.1, R10.1, R11.1, R12.1, R13.1, R14.1, R15.1, R16.1, R17.1, R18.1, R19.1, R20.1, R21.1, R22.1, R23.1, R42.1, R43.1, R44.1, R46.1, R49.1, R50.1
BASE_N0: R19.2, SW3.1
BASE_N1: R20.2, SW3.2
BASE_N2: R21.2, SW3.3
BASE_N3: R22.2, SW3.4
CPLD_XCVR_OE_N: R10.2
DIAG_N: J4.1, R23.2
DIP_N0: R1.2, SW2.1 (SW1)
DIP_N1: R2.2, SW2.2 (SW2)
DIP_N2: R3.2, SW2.3 (SW3)
DIP_N3: R4.2, SW2.4 (SW4)
DIP_N4: R5.2, SW2.5 (SW5)
DIP_N5: R6.2, SW2.6 (SW6)
DIP_N6: R7.2, SW2.7 (SW7)
DIP_N7: R8.2, SW2.8 (SW8)
DIP_N8: R9.2, SW2.9 (SW9)
DIP_N9: R16.2, SW2.10 (SW10)
DIP_N10: R17.2, SW2.11 (SW11)
DIP_N11: R18.2, SW2.12 (SW12)
FLASH_CE_N: R11.2
FLASH_RESET_N: R13.2
FLASH_RYBY_N: R46.2
GND: J4.2, R41.1, SW2.13 (COM12), SW2.14 (COM11), SW2.15 (COM10), SW2.16 (COM9), SW2.17 (COM8), SW2.18 (COM7), SW2.19 (COM6), SW2.20 (COM5), SW2.21 (COM4), SW2.22 (COM3), SW2.23 (COM2), SW2.24 (COM1), SW3.5, SW3.6, SW3.7, SW3.8
HP_MIP_GATE_N: R50.2
MEM_OE_N: R15.2
MEM_WE_N: R12.2
SRAM_CE_N: R14.2
TCK: R41.2
TDI: R43.2
TDO: R44.2
TMS: R42.2
XCVR_OE_N: R49.2

Notes on the sheet:
Configuration switches - open = HIGH; ON/short = LOW
SW2 poles 1-9: option ROMs Pole 10: reserved A/B selector Pole 11: RAM enable; pole 12: system ROM J4: short to enable diagnostic ROM/scratch RAM
External configuration pull-ups (keepers disabled)
Safe idle defaults
Common JTAG biasing - fitted in BOTH assemblies
Use the base/diagnostic selection before boot. Configuration HDL and CPLD pad assignments are retained. All local power bypassing is on sheet 5.
