MattisLind/hp9835_unified_ram_rom_board/kicad/hp9835_unified_ram_rom_board/decoupling.kicad_sch

## KiCad design kicad/hp9835_unified_ram_rom_board/decoupling.kicad_sch (2026-11-07)

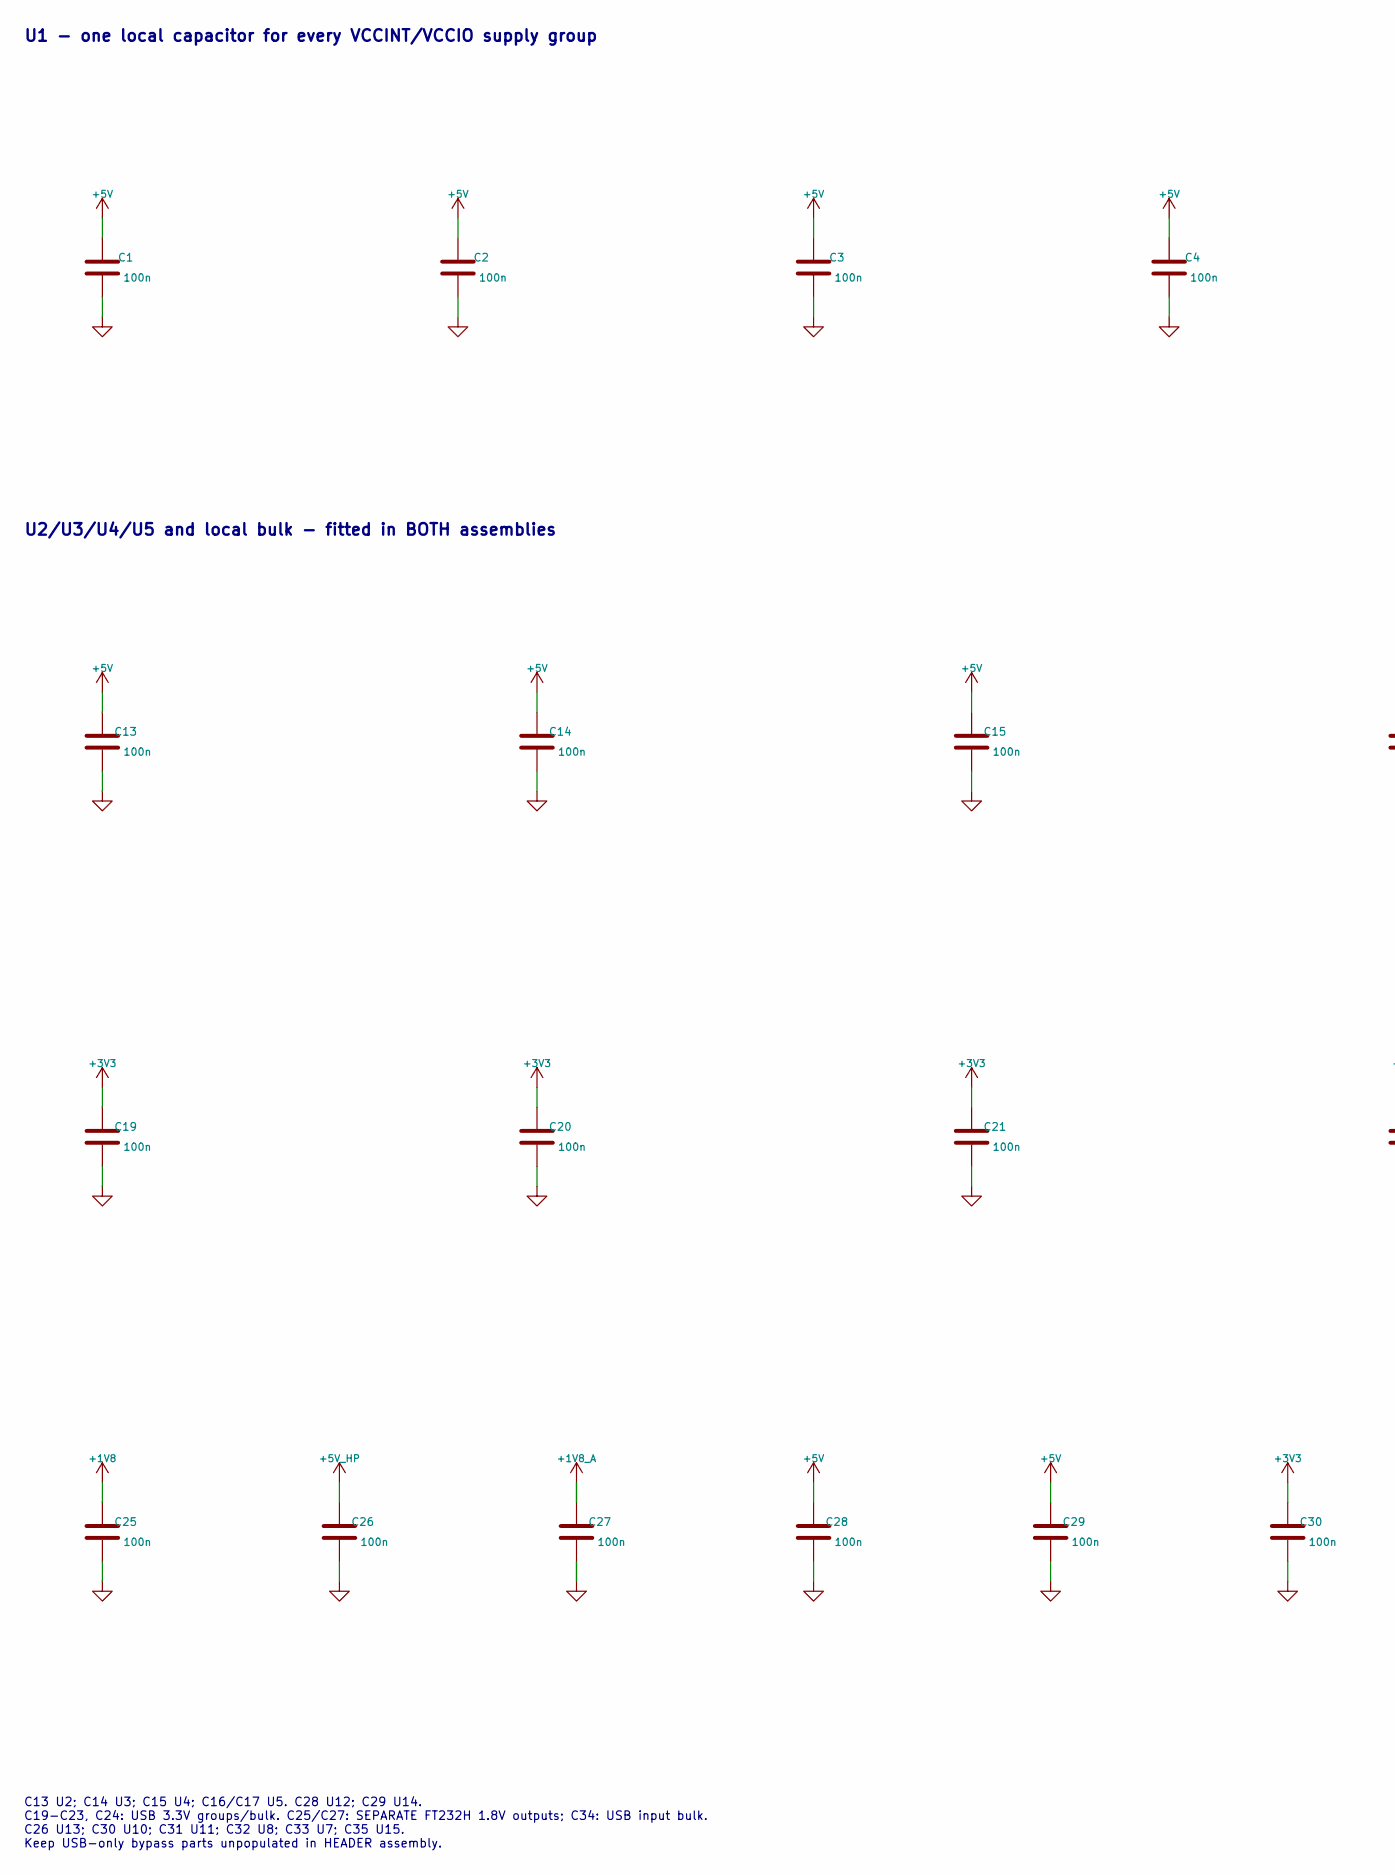
[picture p32: schematic decoupling.kicad_sch, part in row 1, column 1]

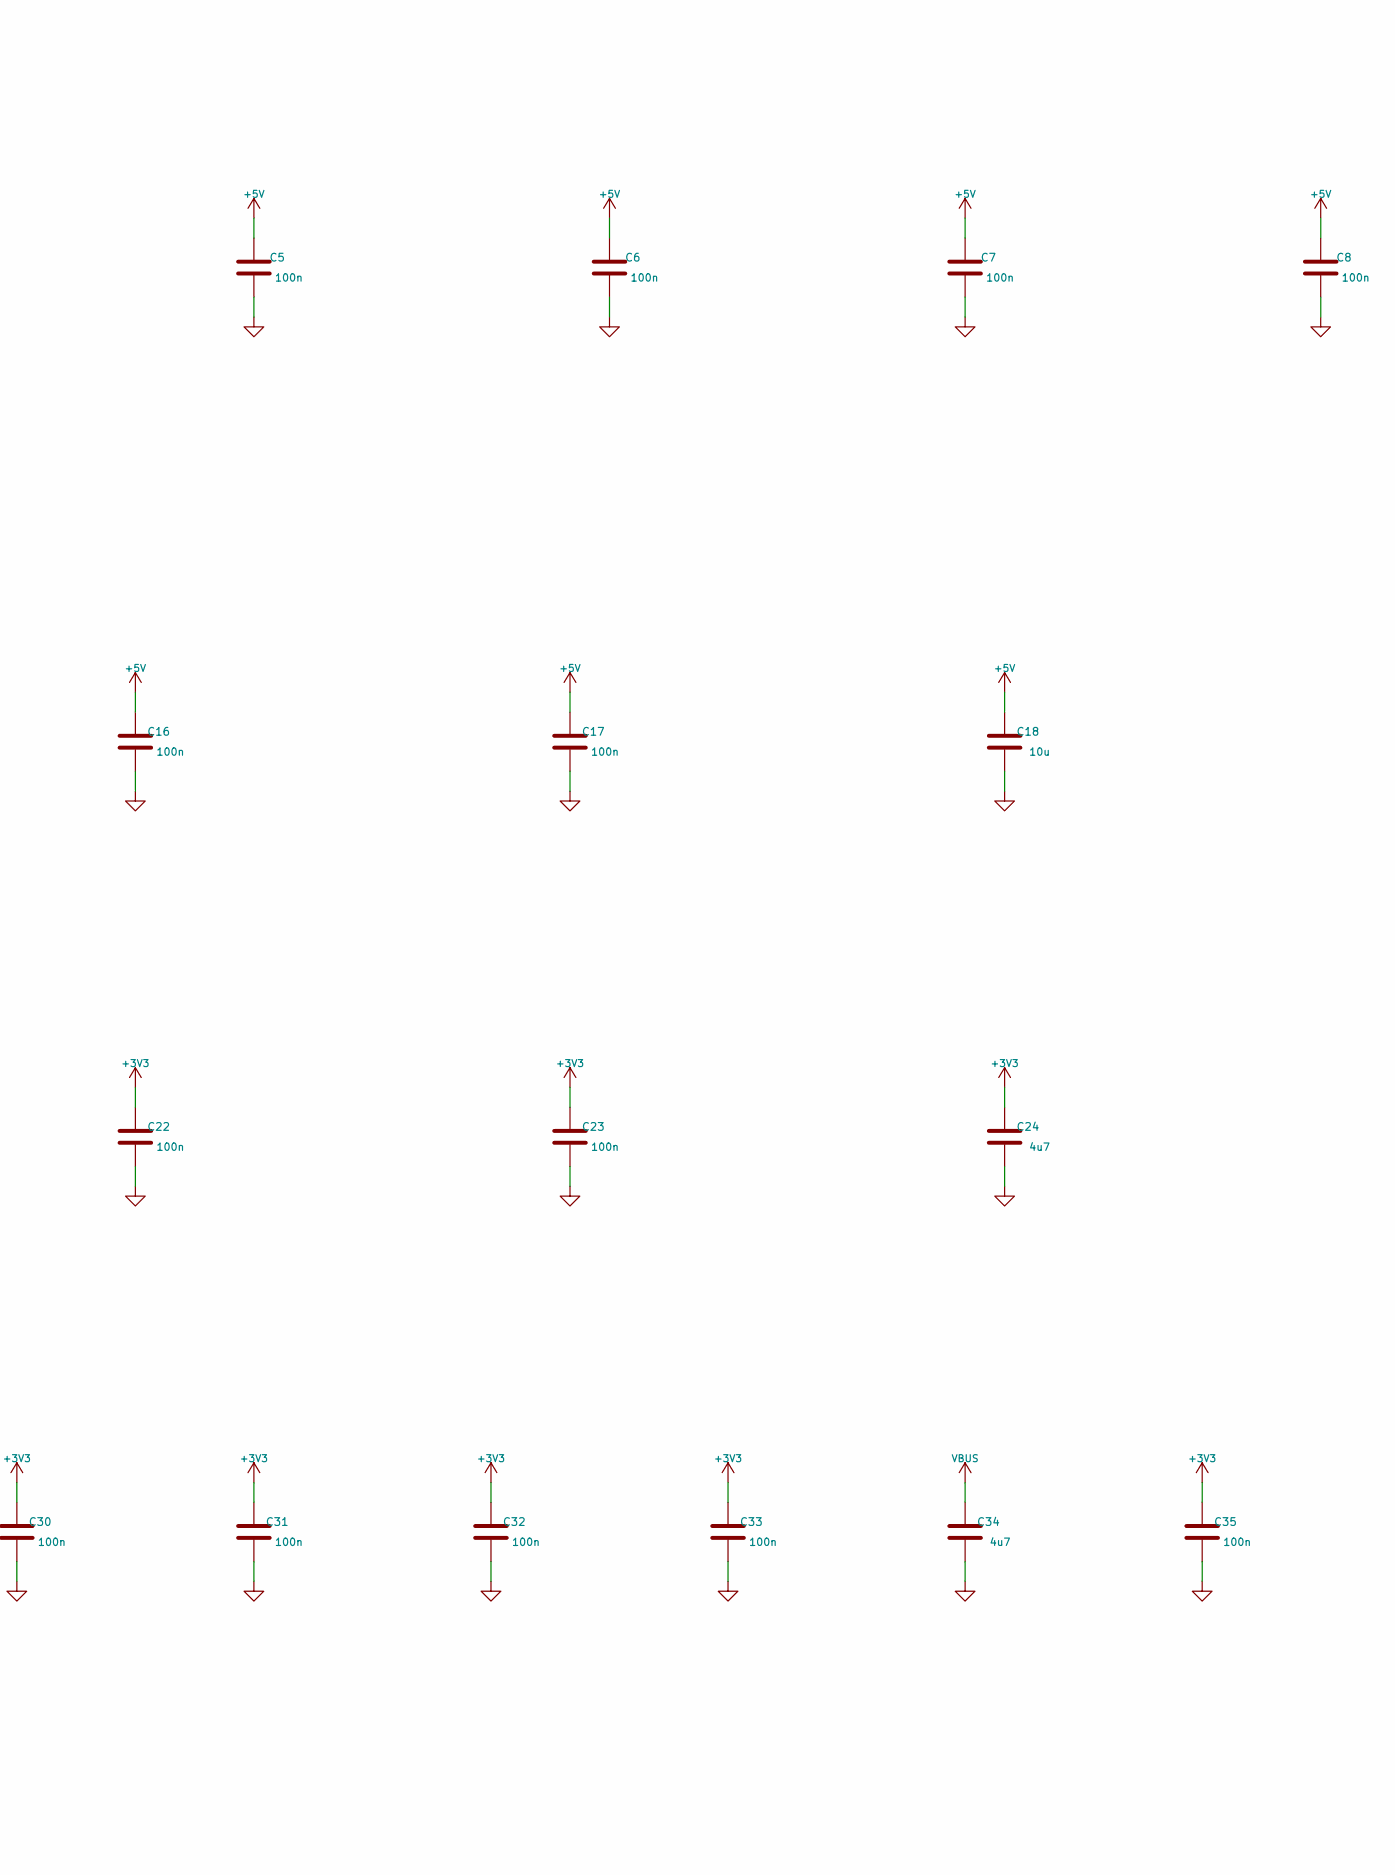
[picture p33: schematic decoupling.kicad_sch, part in row 1, column 2]

Parts:
C1, C2, C3, C4, C5, C6, C7, C8, C13, C14, C15, C16, C17, C19, C20, C21, C22, C23, C25, C26, C27, C28, C29, C30, C31, C32, C33, C35: 100n; C_0805_2012Metric
C18: 10u; C_0805_2012Metric
C24, C34: 4u7; C_0805_2012Metric

Connections:
+1V8: C25.1
+1V8_A: C27.1
+3V3: C19.1, C20.1, C21.1, C22.1, C23.1, C24.1, C30.1, C31.1, C32.1, C33.1, C35.1
+5V: C1.1, C2.1, C3.1, C4.1, C5.1, C6.1, C7.1, C8.1, C13.1, C14.1, C15.1, C16.1, C17.1, C18.1, C28.1, C29.1
+5V_HP: C26.1
GND: C1.2, C2.2, C3.2, C4.2, C5.2, C6.2, C7.2, C8.2, C13.2, C14.2, C15.2, C16.2, C17.2, C18.2, C19.2, C20.2, C21.2, C22.2, C23.2, C24.2, C25.2, C26.2, C27.2, C28.2, C29.2, C30.2, C31.2, C32.2, C33.2, C34.2, C35.2
VBUS: C34.1

Notes on the sheet:
U1 - one local capacitor for every VCCINT/VCCIO supply group
U2/U3/U4/U5 and local bulk - fitted in BOTH assemblies
C13 U2; C14 U3; C15 U4; C16/C17 U5. C28 U12; C29 U14. C19-C23, C24: USB 3.3V groups/bulk. C25/C27: SEPARATE FT232H 1.8V outputs; C34: USB input bulk. C26 U13; C30 U10; C31 U11; C32 U8; C33 U7; C35 U15. Keep USB-only bypass parts unpopulated in HEADER assembly.
