MattisLind/hp9835_unified_ram_rom_board/kicad/hp9835_unified_ram_rom_board/hp9835_unified_ram_rom_board.kicad_sch

## KiCad design kicad/hp9835_unified_ram_rom_board/hp9835_unified_ram_rom_board.kicad_sch (2026-11-07)

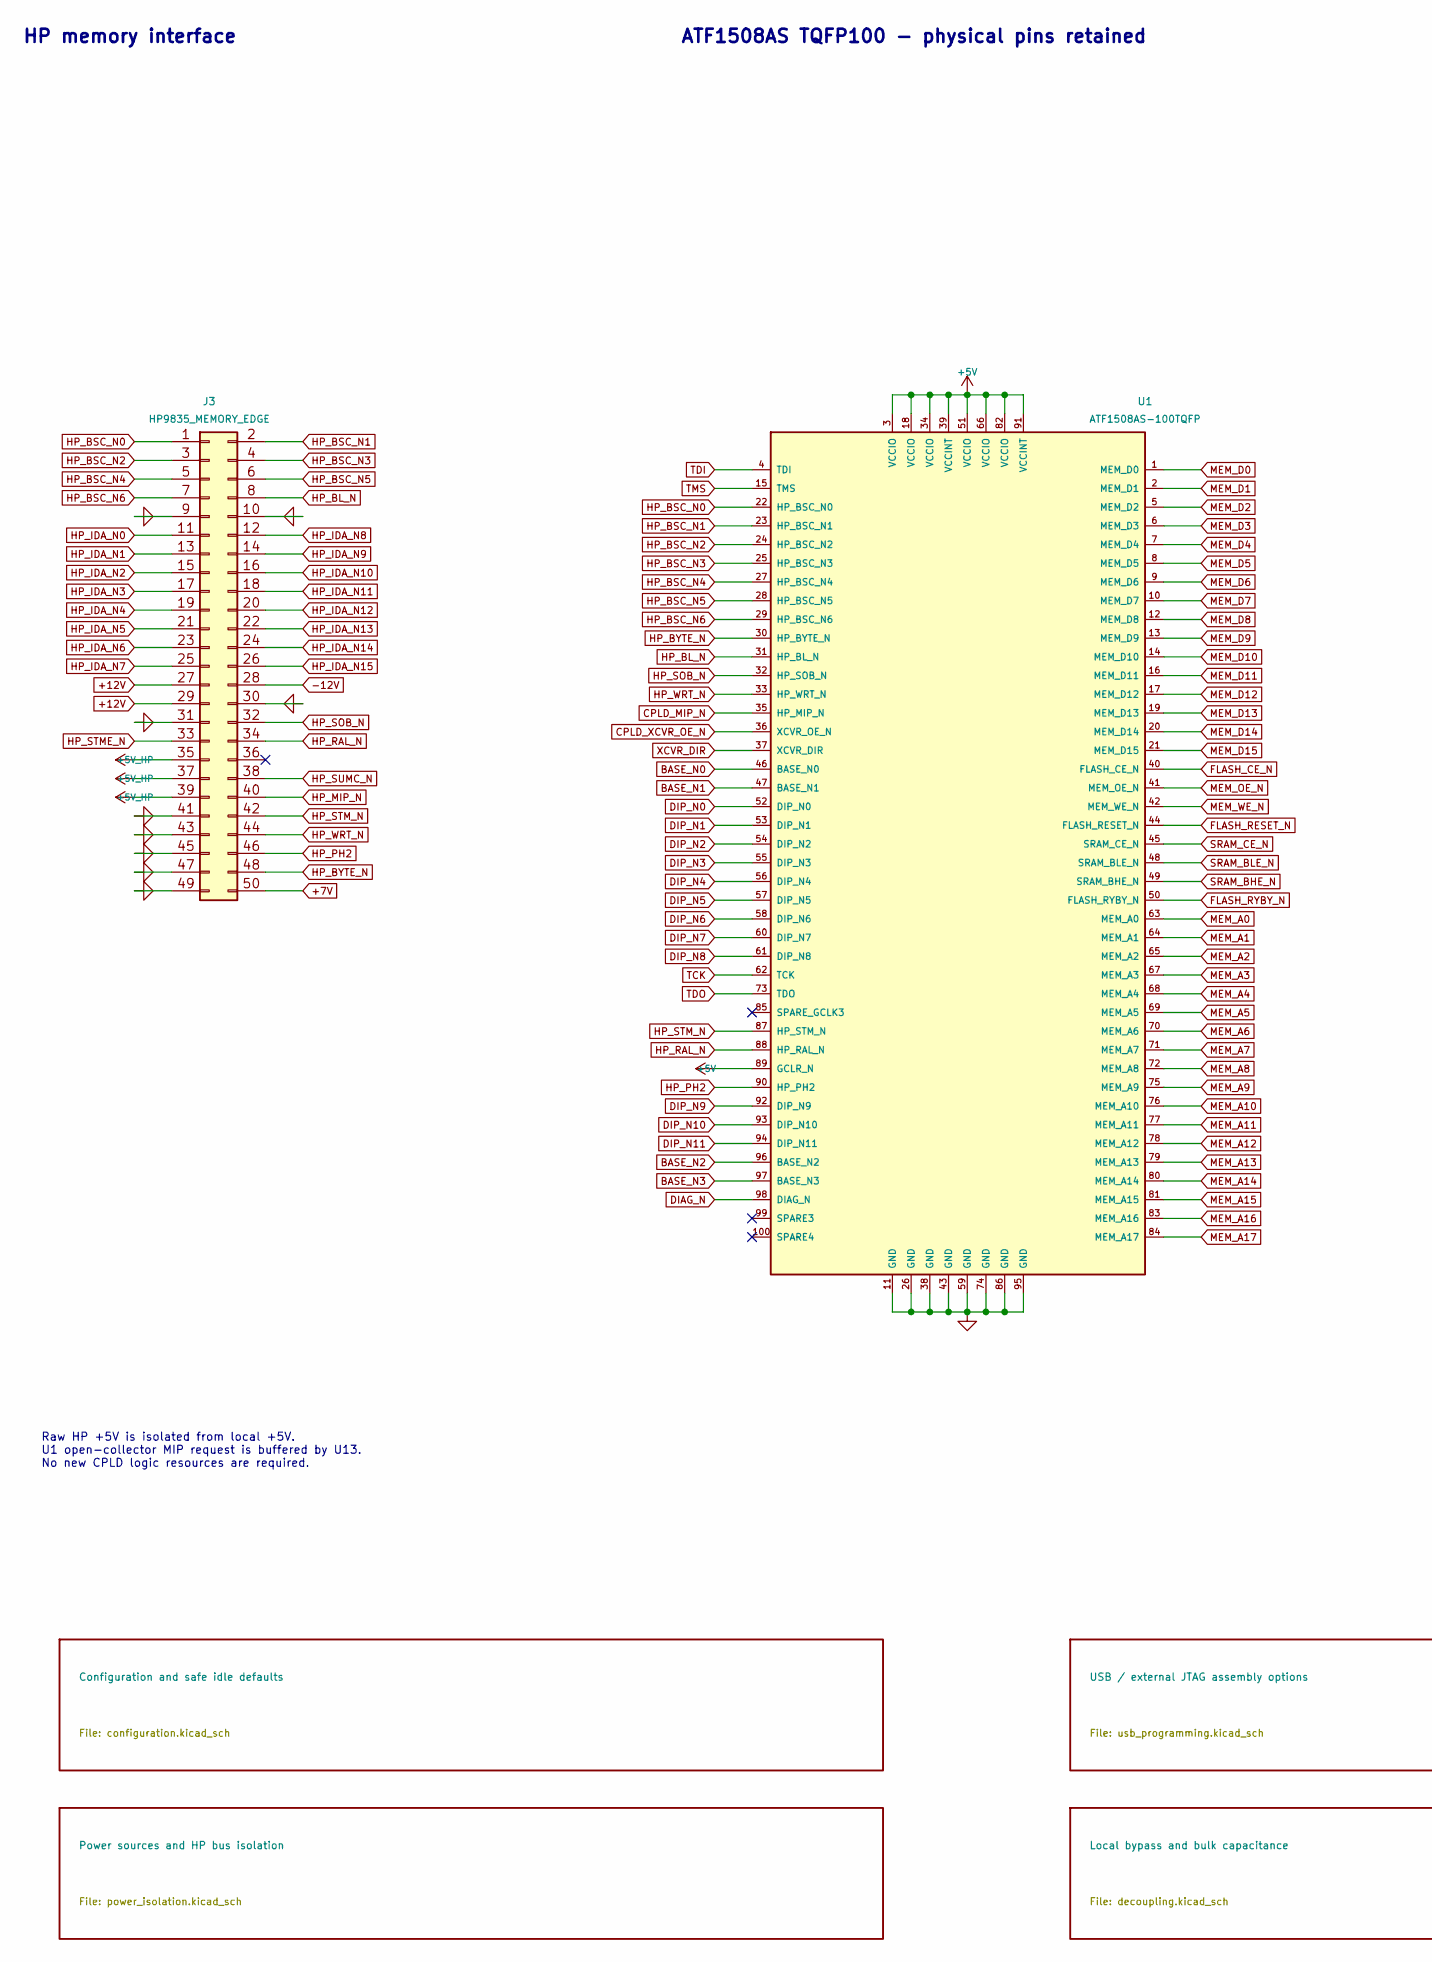
[picture p34: schematic hp9835_unified_ram_rom_board.kicad_sch, part in row 1, column 1]

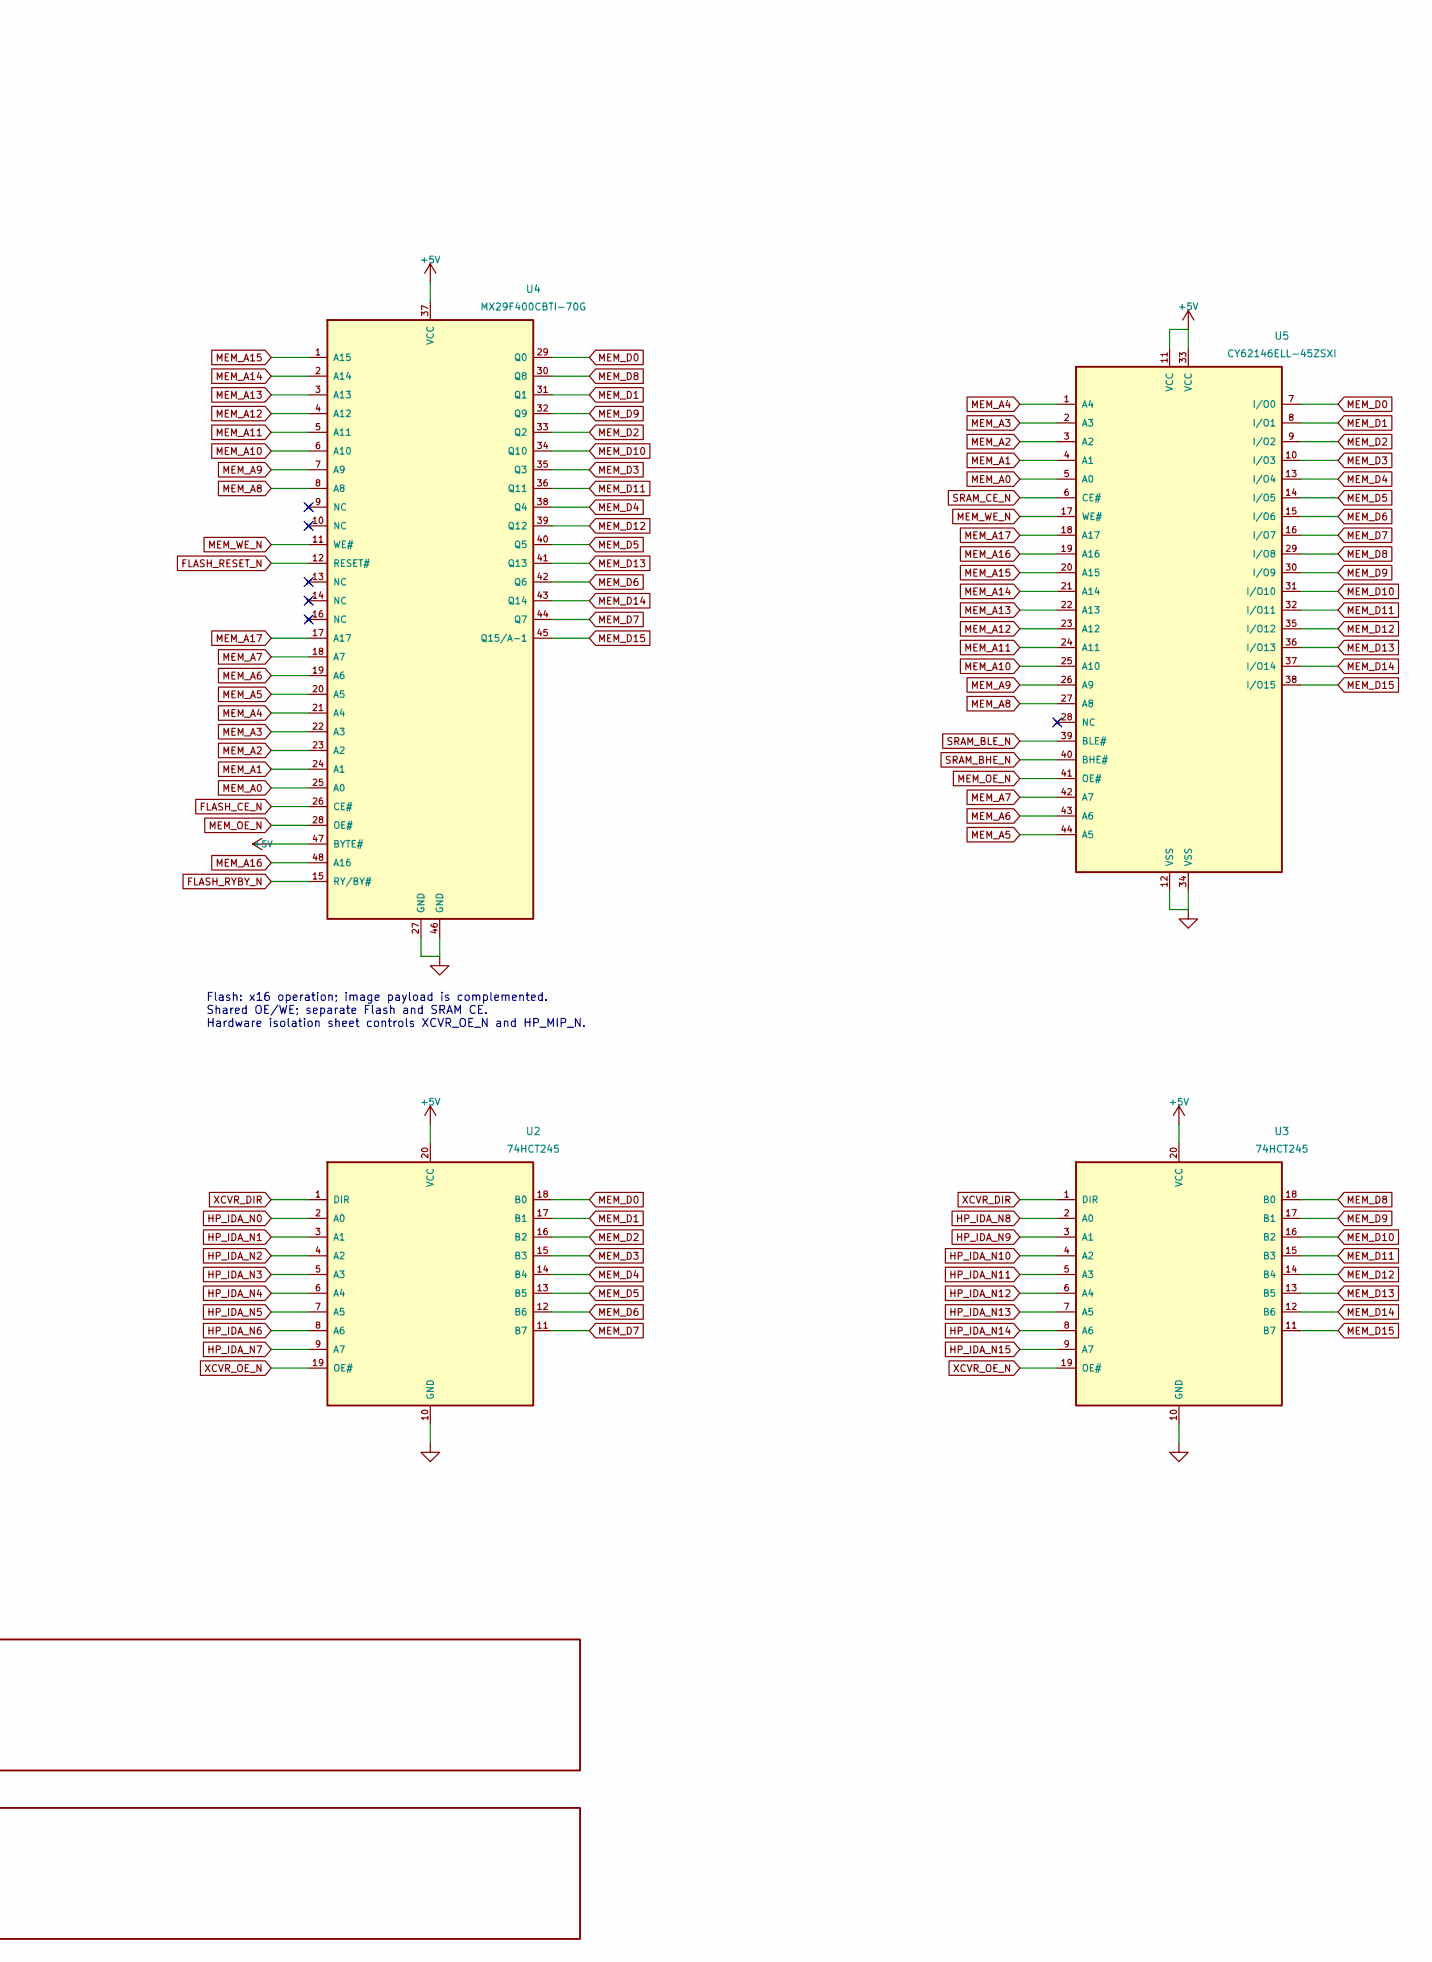
[picture p35: schematic hp9835_unified_ram_rom_board.kicad_sch, part in row 1, column 2]

Parts:
J3: HP9835_MEMORY_EDGE; HP9835_MemoryBus_Edge_2x25_P2.54mm
U1: ATF1508AS-100TQFP; TQFP-100_14x14mm_P0.5mm
U2, U3: 74HCT245; SOIC-20W_7.5x12.8mm_P1.27mm
U4: MX29F400CBTI-70G; TSOP-I-48_18.4x12mm_P0.5mm
U5: CY62146ELL-45ZSXI; TSOP-II-44_10.16x18.41mm_P0.8mm

Connections:
+5V: U1.3 (VCCIO), U1.18 (VCCIO), U1.34 (VCCIO), U1.39 (VCCINT), U1.51 (VCCIO), U1.66 (VCCIO), U1.82 (VCCIO), U1.89 (GCLR_N), U1.91 (VCCINT), U2.20 (VCC), U3.20 (VCC), U4.37 (VCC), U4.47 (BYTE#), U5.11 (VCC), U5.33 (VCC)
+5V_HP: J3.35, J3.37, J3.39
+7V: J3.50
+12V: J3.27, J3.29
-12V: J3.28
BASE_N0: U1.46 (BASE_N0)
BASE_N1: U1.47 (BASE_N1)
BASE_N2: U1.96 (BASE_N2)
BASE_N3: U1.97 (BASE_N3)
CPLD_MIP_N: U1.35 (HP_MIP_N)
CPLD_XCVR_OE_N: U1.36 (XCVR_OE_N)
DIAG_N: U1.98 (DIAG_N)
DIP_N0: U1.52 (DIP_N0)
DIP_N1: U1.53 (DIP_N1)
DIP_N2: U1.54 (DIP_N2)
DIP_N3: U1.55 (DIP_N3)
DIP_N4: U1.56 (DIP_N4)
DIP_N5: U1.57 (DIP_N5)
DIP_N6: U1.58 (DIP_N6)
DIP_N7: U1.60 (DIP_N7)
DIP_N8: U1.61 (DIP_N8)
DIP_N9: U1.92 (DIP_N9)
DIP_N10: U1.93 (DIP_N10)
DIP_N11: U1.94 (DIP_N11)
FLASH_CE_N: U1.40 (FLASH_CE_N), U4.26 (CE#)
FLASH_RESET_N: U1.44 (FLASH_RESET_N), U4.12 (RESET#)
FLASH_RYBY_N: U1.50 (FLASH_RYBY_N), U4.15 (RY/BY#)
GND: J3.9, J3.10, J3.30, J3.31, J3.41, J3.43, J3.45, J3.47, J3.49, U1.11 (GND), U1.26 (GND), U1.38 (GND), U1.43 (GND), U1.59 (GND), U1.74 (GND), U1.86 (GND), U1.95 (GND), U2.10 (GND), U3.10 (GND), U4.27 (GND), U4.46 (GND), U5.12 (VSS), U5.34 (VSS)
HP_BL_N: J3.8, U1.31 (HP_BL_N)
HP_BSC_N0: J3.1, U1.22 (HP_BSC_N0)
HP_BSC_N1: J3.2, U1.23 (HP_BSC_N1)
HP_BSC_N2: J3.3, U1.24 (HP_BSC_N2)
HP_BSC_N3: J3.4, U1.25 (HP_BSC_N3)
HP_BSC_N4: J3.5, U1.27 (HP_BSC_N4)
HP_BSC_N5: J3.6, U1.28 (HP_BSC_N5)
HP_BSC_N6: J3.7, U1.29 (HP_BSC_N6)
HP_BYTE_N: J3.48, U1.30 (HP_BYTE_N)
HP_IDA_N0: J3.11, U2.2 (A0)
HP_IDA_N1: J3.13, U2.3 (A1)
HP_IDA_N2: J3.15, U2.4 (A2)
HP_IDA_N3: J3.17, U2.5 (A3)
HP_IDA_N4: J3.19, U2.6 (A4)
HP_IDA_N5: J3.21, U2.7 (A5)
HP_IDA_N6: J3.23, U2.8 (A6)
HP_IDA_N7: J3.25, U2.9 (A7)
HP_IDA_N8: J3.12, U3.2 (A0)
HP_IDA_N9: J3.14, U3.3 (A1)
HP_IDA_N10: J3.16, U3.4 (A2)
HP_IDA_N11: J3.18, U3.5 (A3)
HP_IDA_N12: J3.20, U3.6 (A4)
HP_IDA_N13: J3.22, U3.7 (A5)
HP_IDA_N14: J3.24, U3.8 (A6)
HP_IDA_N15: J3.26, U3.9 (A7)
HP_MIP_N: J3.40
HP_PH2: J3.46, U1.90 (HP_PH2)
HP_RAL_N: J3.34, U1.88 (HP_RAL_N)
HP_SOB_N: J3.32, U1.32 (HP_SOB_N)
HP_STME_N: J3.33
HP_STM_N: J3.42, U1.87 (HP_STM_N)
HP_SUMC_N: J3.38
HP_WRT_N: J3.44, U1.33 (HP_WRT_N)
MEM_A0: U1.63 (MEM_A0), U4.25 (A0), U5.5 (A0)
MEM_A1: U1.64 (MEM_A1), U4.24 (A1), U5.4 (A1)
MEM_A2: U1.65 (MEM_A2), U4.23 (A2), U5.3 (A2)
MEM_A3: U1.67 (MEM_A3), U4.22 (A3), U5.2 (A3)
MEM_A4: U1.68 (MEM_A4), U4.21 (A4), U5.1 (A4)
MEM_A5: U1.69 (MEM_A5), U4.20 (A5), U5.44 (A5)
MEM_A6: U1.70 (MEM_A6), U4.19 (A6), U5.43 (A6)
MEM_A7: U1.71 (MEM_A7), U4.18 (A7), U5.42 (A7)
MEM_A8: U1.72 (MEM_A8), U4.8 (A8), U5.27 (A8)
MEM_A9: U1.75 (MEM_A9), U4.7 (A9), U5.26 (A9)
MEM_A10: U1.76 (MEM_A10), U4.6 (A10), U5.25 (A10)
MEM_A11: U1.77 (MEM_A11), U4.5 (A11), U5.24 (A11)
MEM_A12: U1.78 (MEM_A12), U4.4 (A12), U5.23 (A12)
MEM_A13: U1.79 (MEM_A13), U4.3 (A13), U5.22 (A13)
MEM_A14: U1.80 (MEM_A14), U4.2 (A14), U5.21 (A14)
MEM_A15: U1.81 (MEM_A15), U4.1 (A15), U5.20 (A15)
MEM_A16: U1.83 (MEM_A16), U4.48 (A16), U5.19 (A16)
MEM_A17: U1.84 (MEM_A17), U4.17 (A17), U5.18 (A17)
MEM_D0: U1.1 (MEM_D0), U2.18 (B0), U4.29 (Q0), U5.7 (I/O0)
MEM_D1: U1.2 (MEM_D1), U2.17 (B1), U4.31 (Q1), U5.8 (I/O1)
MEM_D2: U1.5 (MEM_D2), U2.16 (B2), U4.33 (Q2), U5.9 (I/O2)
MEM_D3: U1.6 (MEM_D3), U2.15 (B3), U4.35 (Q3), U5.10 (I/O3)
MEM_D4: U1.7 (MEM_D4), U2.14 (B4), U4.38 (Q4), U5.13 (I/O4)
MEM_D5: U1.8 (MEM_D5), U2.13 (B5), U4.40 (Q5), U5.14 (I/O5)
MEM_D6: U1.9 (MEM_D6), U2.12 (B6), U4.42 (Q6), U5.15 (I/O6)
MEM_D7: U1.10 (MEM_D7), U2.11 (B7), U4.44 (Q7), U5.16 (I/O7)
MEM_D8: U1.12 (MEM_D8), U3.18 (B0), U4.30 (Q8), U5.29 (I/O8)
MEM_D9: U1.13 (MEM_D9), U3.17 (B1), U4.32 (Q9), U5.30 (I/O9)
MEM_D10: U1.14 (MEM_D10), U3.16 (B2), U4.34 (Q10), U5.31 (I/O10)
MEM_D11: U1.16 (MEM_D11), U3.15 (B3), U4.36 (Q11), U5.32 (I/O11)
MEM_D12: U1.17 (MEM_D12), U3.14 (B4), U4.39 (Q12), U5.35 (I/O12)
MEM_D13: U1.19 (MEM_D13), U3.13 (B5), U4.41 (Q13), U5.36 (I/O13)
MEM_D14: U1.20 (MEM_D14), U3.12 (B6), U4.43 (Q14), U5.37 (I/O14)
MEM_D15: U1.21 (MEM_D15), U3.11 (B7), U4.45 (Q15/A-1), U5.38 (I/O15)
MEM_OE_N: U1.41 (MEM_OE_N), U4.28 (OE#), U5.41 (OE#)
MEM_WE_N: U1.42 (MEM_WE_N), U4.11 (WE#), U5.17 (WE#)
SRAM_BHE_N: U1.49 (SRAM_BHE_N), U5.40 (BHE#)
SRAM_BLE_N: U1.48 (SRAM_BLE_N), U5.39 (BLE#)
SRAM_CE_N: U1.45 (SRAM_CE_N), U5.6 (CE#)
TCK: U1.62 (TCK)
TDI: U1.4 (TDI)
TDO: U1.73 (TDO)
TMS: U1.15 (TMS)
XCVR_DIR: U1.37 (XCVR_DIR), U2.1 (DIR), U3.1 (DIR)
XCVR_OE_N: U2.19 (OE#), U3.19 (OE#)

Notes on the sheet:
HP memory interface
ATF1508AS TQFP100 - physical pins retained
Flash: x16 operation; image payload is complemented. Shared OE/WE; separate Flash and SRAM CE. Hardware isolation sheet controls XCVR_OE_N and HP_MIP_N.
Raw HP +5V is isolated from local +5V. U1 open-collector MIP request is buffered by U13. No new CPLD logic resources are required.
