MattisLind/hp9835_unified_ram_rom_board/kicad/hp9835_unified_ram_rom_board/power_isolation.kicad_sch

## KiCad design kicad/hp9835_unified_ram_rom_board/power_isolation.kicad_sch (2026-11-07)

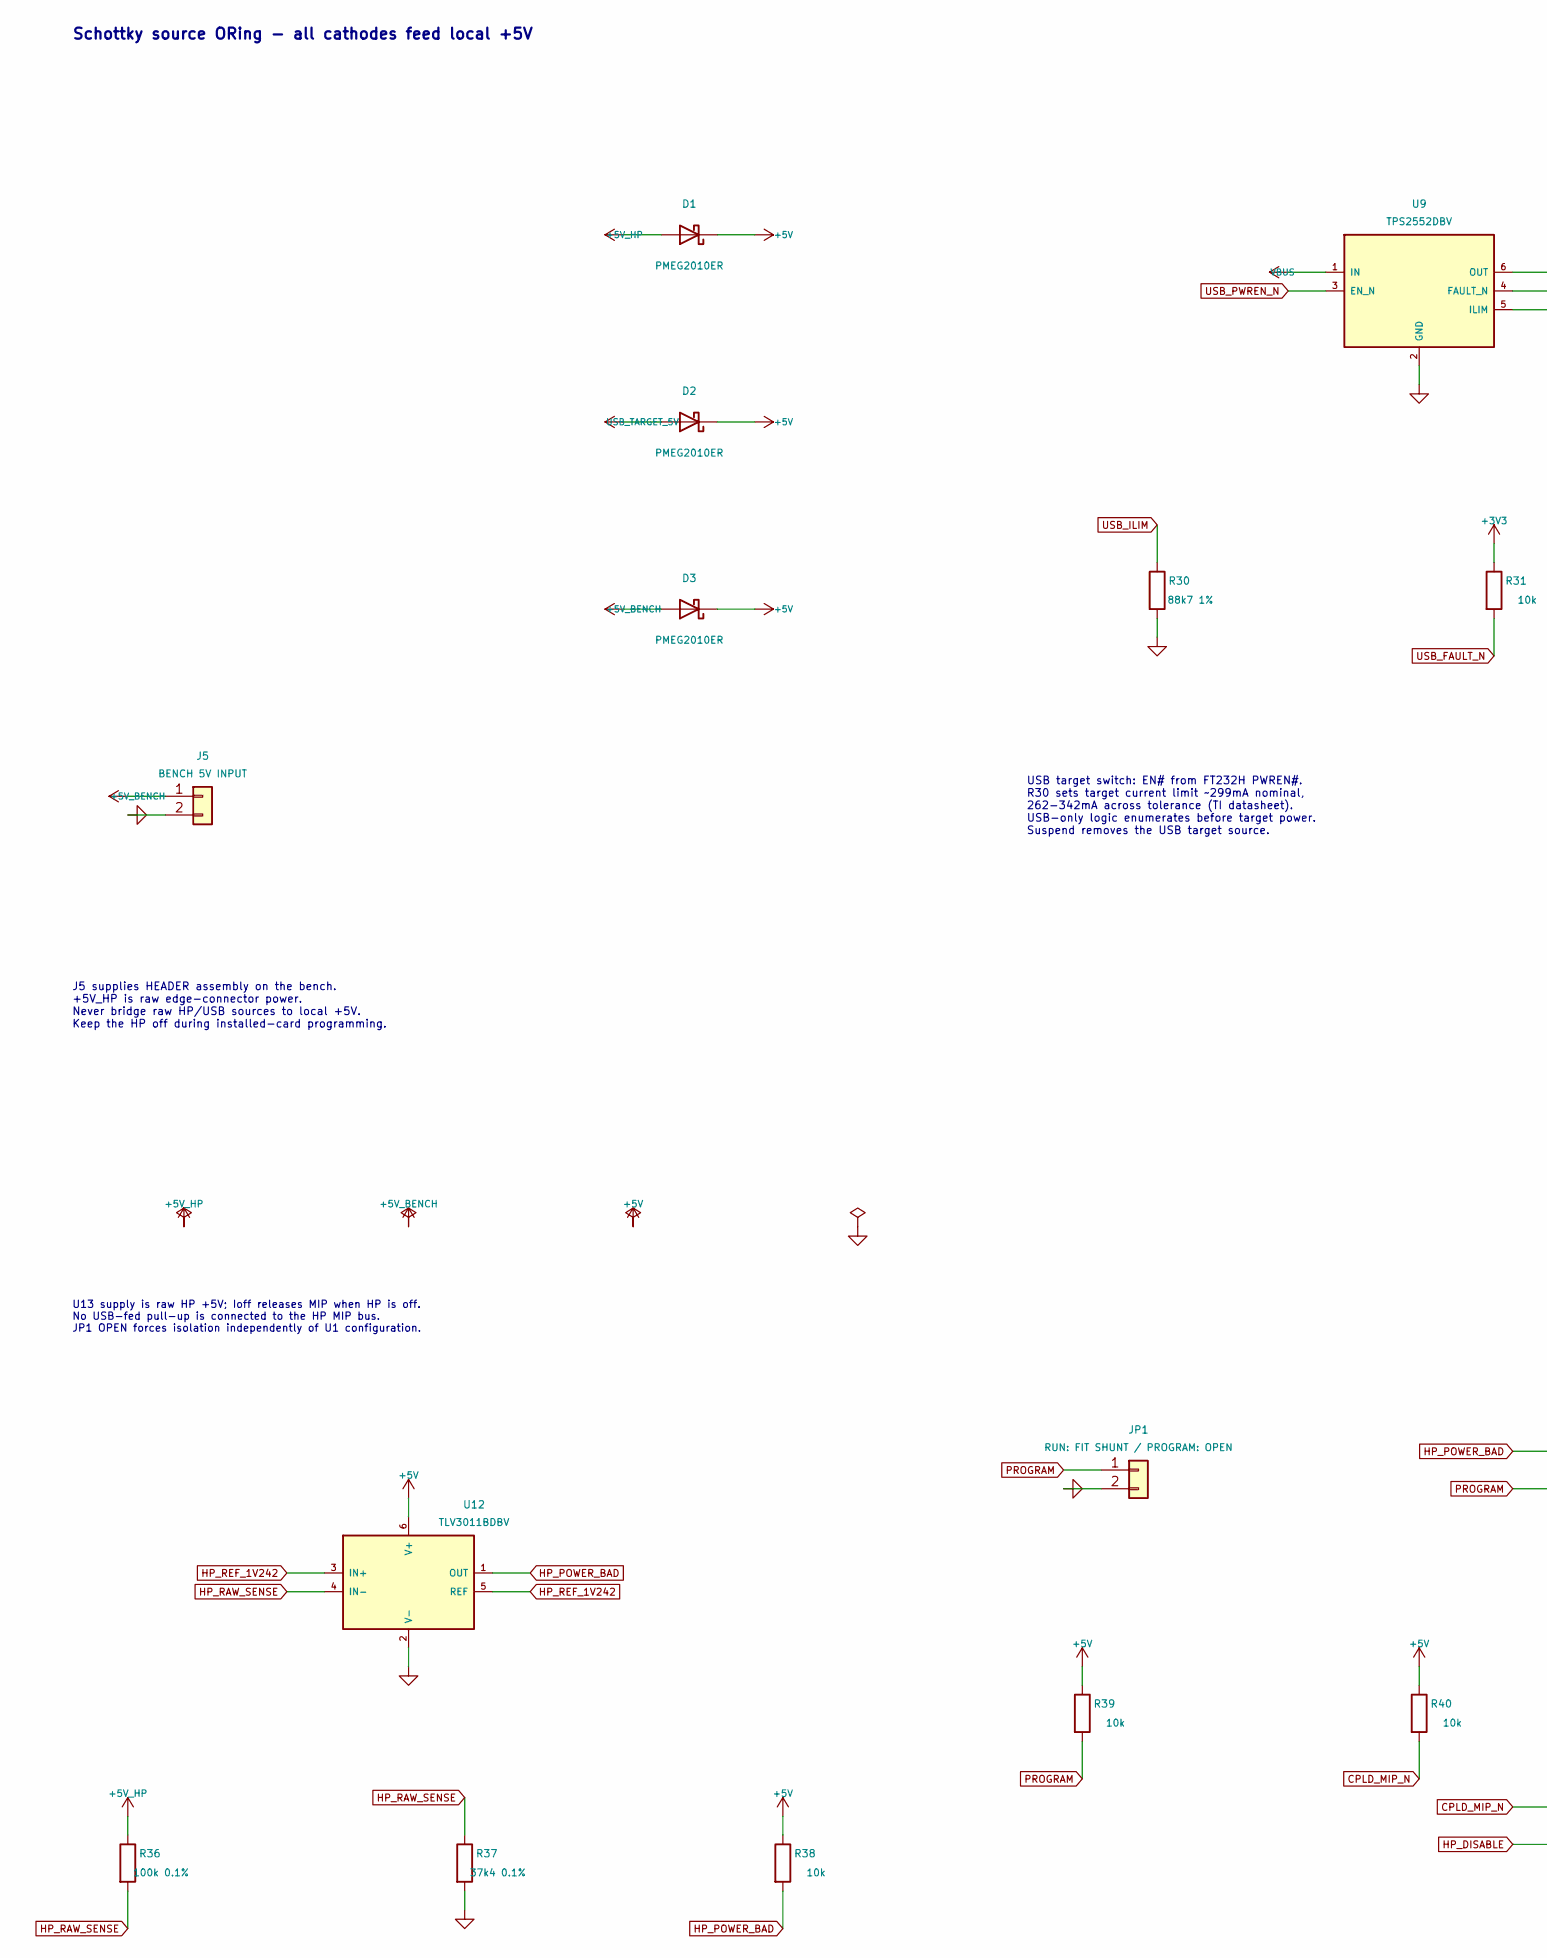
[picture p36: schematic power_isolation.kicad_sch, part in row 1, column 1]

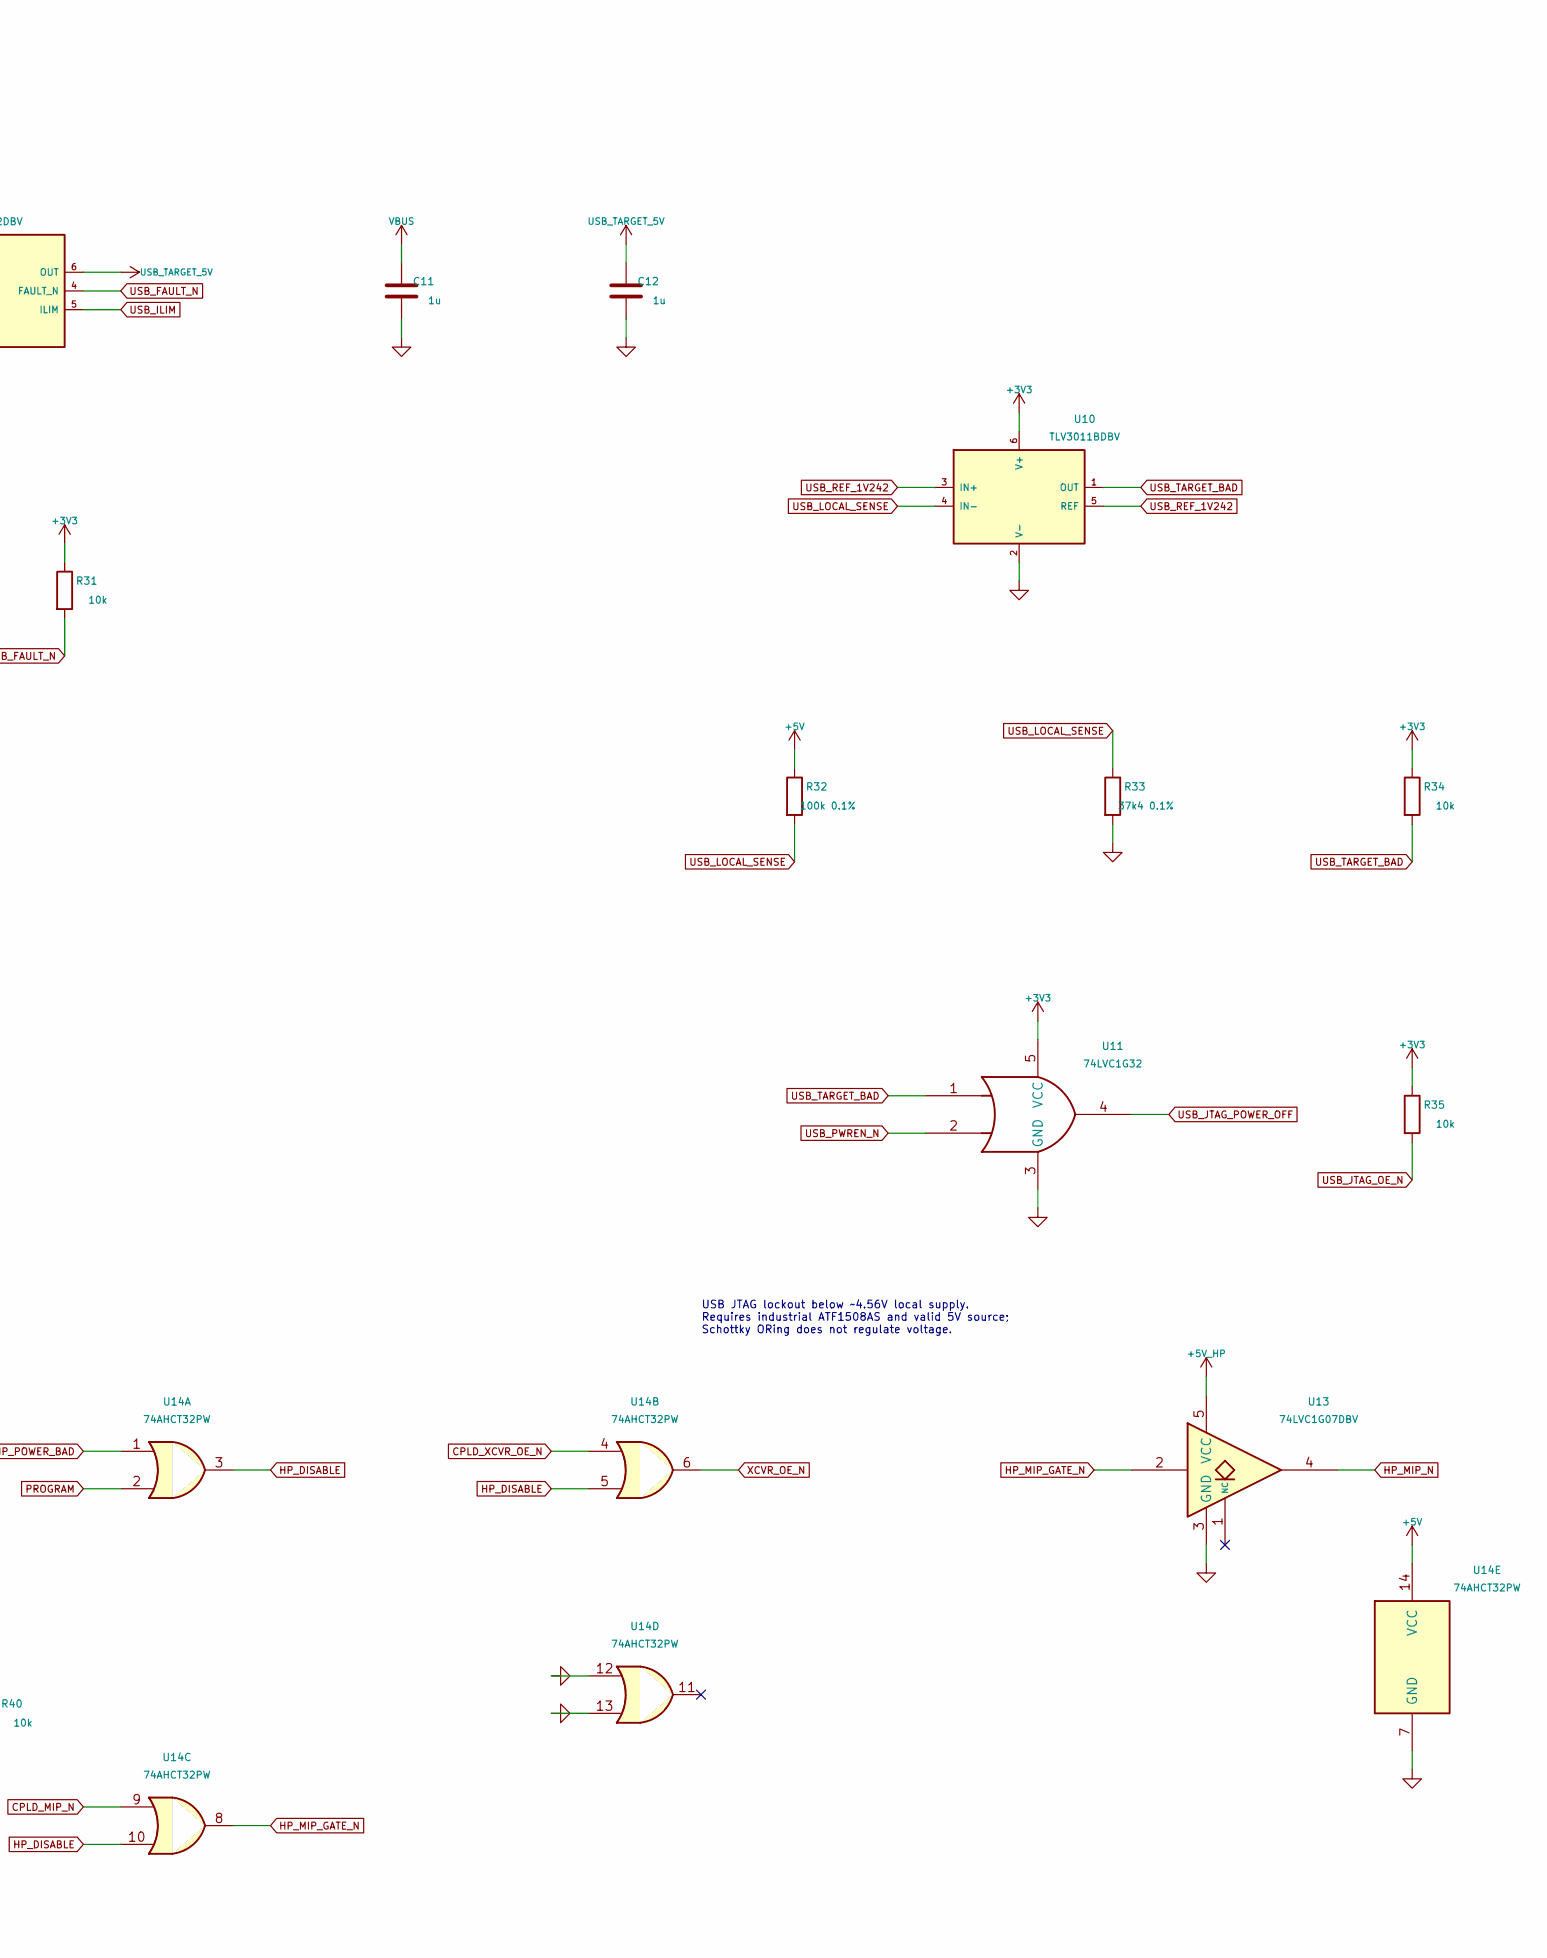
[picture p37: schematic power_isolation.kicad_sch, part in row 1, column 2]

Parts:
C11, C12: 1u; C_0805_2012Metric
D1, D2, D3: PMEG2010ER; Nexperia_CFP3_SOD-123W
J5: BENCH 5V INPUT; PinHeader_1x02_P2.54mm_Vertical
JP1: RUN: FIT SHUNT / PROGRAM: OPEN; PinHeader_1x02_P2.54mm_Vertical
R30: 88k7 1%; R_0805_2012Metric
R31, R34, R35, R38, R39, R40: 10k; R_0805_2012Metric
R32, R36: 100k 0.1%; R_0805_2012Metric
R33, R37: 37k4 0.1%; R_0805_2012Metric
U9: TPS2552DBV; SOT-23-6
U10, U12: TLV3011BDBV; SOT-23-6
U11: 74LVC1G32; SOT-23-5
U13: 74LVC1G07DBV; SOT-23-5
U14: 74AHCT32PW; TSSOP-14_4.4x5mm_P0.65mm

Connections:
+3V3: R31.1, R34.1, R35.1, U10.6 (V+), U11.5 (VCC)
+5V: D1.1 (K), D2.1 (K), D3.1 (K), R32.1, R38.1, R39.1, R40.1, U12.6 (V+), U14.14 (VCC)
+5V_BENCH: D3.2 (A), J5.1
+5V_HP: D1.2 (A), R36.1, U13.5 (VCC)
CPLD_MIP_N: R40.2, U14.9
CPLD_XCVR_OE_N: U14.4
GND: C11.2, C12.2, J5.2, JP1.2, R30.2, R33.2, R37.2, U9.2 (GND), U10.2 (V-), U11.3 (GND), U12.2 (V-), U13.3 (GND), U14.7 (GND), U14.12, U14.13
HP_DISABLE: U14.3, U14.5, U14.10
HP_MIP_GATE_N: U13.2, U14.8
HP_MIP_N: U13.4
HP_POWER_BAD: R38.2, U12.1 (OUT), U14.1
HP_RAW_SENSE: R36.2, R37.1, U12.4 (IN-)
HP_REF_1V242: U12.3 (IN+), U12.5 (REF)
PROGRAM: JP1.1, R39.2, U14.2
USB_FAULT_N: R31.2, U9.4 (FAULT_N)
USB_ILIM: R30.1, U9.5 (ILIM)
USB_JTAG_OE_N: R35.2
USB_JTAG_POWER_OFF: U11.4
USB_LOCAL_SENSE: R32.2, R33.1, U10.4 (IN-)
USB_PWREN_N: U9.3 (EN_N), U11.2
USB_REF_1V242: U10.3 (IN+), U10.5 (REF)
USB_TARGET_5V: C12.1, D2.2 (A), U9.6 (OUT)
USB_TARGET_BAD: R34.2, U10.1 (OUT), U11.1
VBUS: C11.1, U9.1 (IN)
XCVR_OE_N: U14.6

Notes on the sheet:
Schottky source ORing - all cathodes feed local +5V
J5 supplies HEADER assembly on the bench. +5V_HP is raw edge-connector power. Never bridge raw HP/USB sources to local +5V. Keep the HP off during installed-card programming.
USB target switch: EN# from FT232H PWREN#. R30 sets target current limit ~299mA nominal, 262-342mA across tolerance (TI datasheet). USB-only logic enumerates before target power. Suspend removes the USB target source.
USB JTAG lockout below ~4.56V local supply. Requires industrial ATF1508AS and valid 5V source; Schottky ORing does not regulate voltage.
U13 supply is raw HP +5V; Ioff releases MIP when HP is off. No USB-fed pull-up is connected to the HP MIP bus. JP1 OPEN forces isolation independently of U1 configuration.
