MattisLind/hp9835_unified_ram_rom_board/kicad/hp9835_unified_ram_rom_board/usb_programming.kicad_sch

## KiCad design kicad/hp9835_unified_ram_rom_board/usb_programming.kicad_sch (2026-11-07)

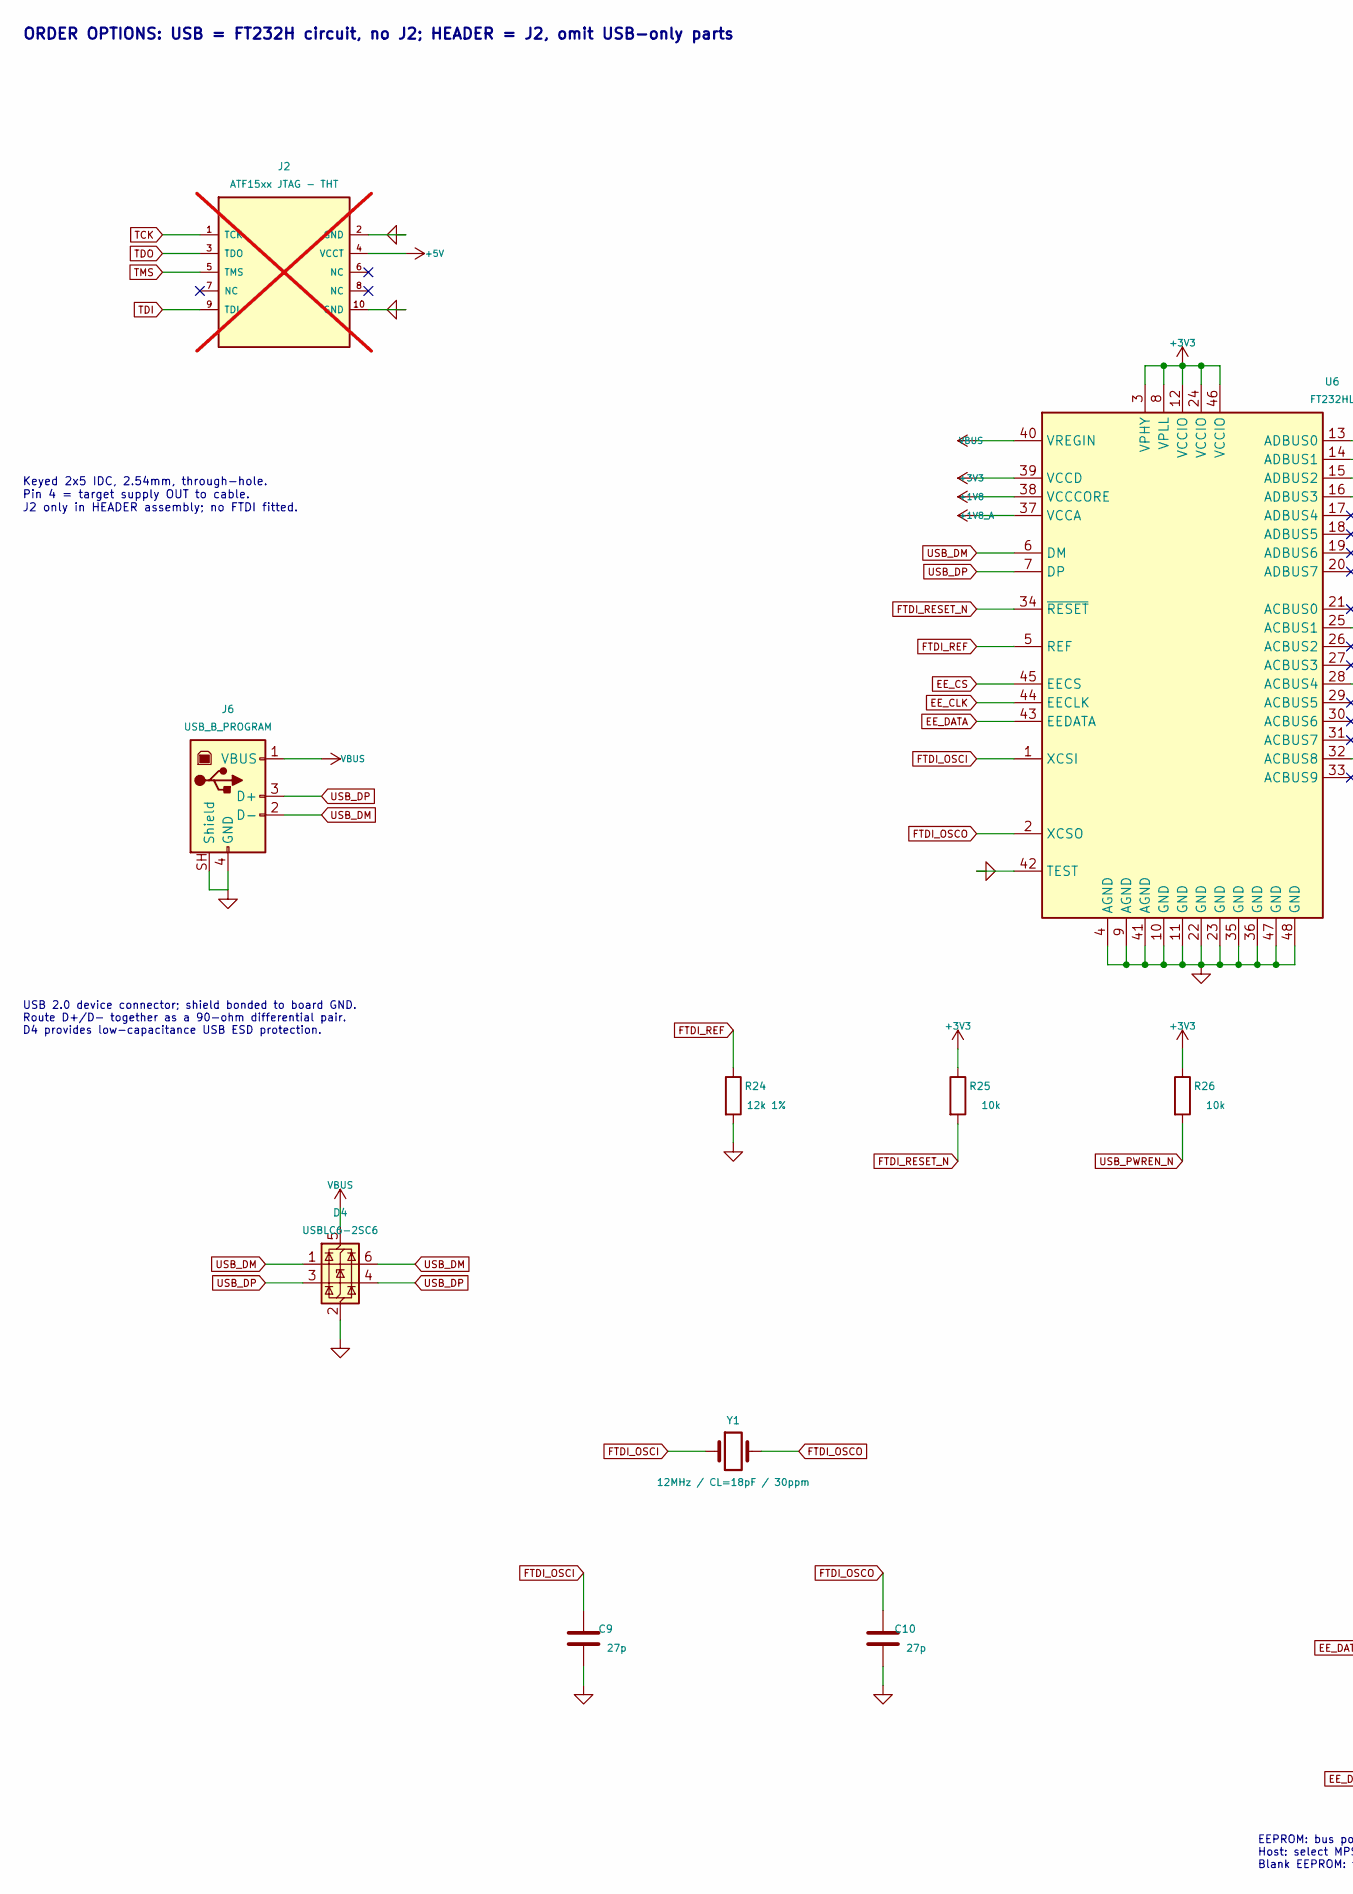
[picture p38: schematic usb_programming.kicad_sch, part in row 1, column 1]

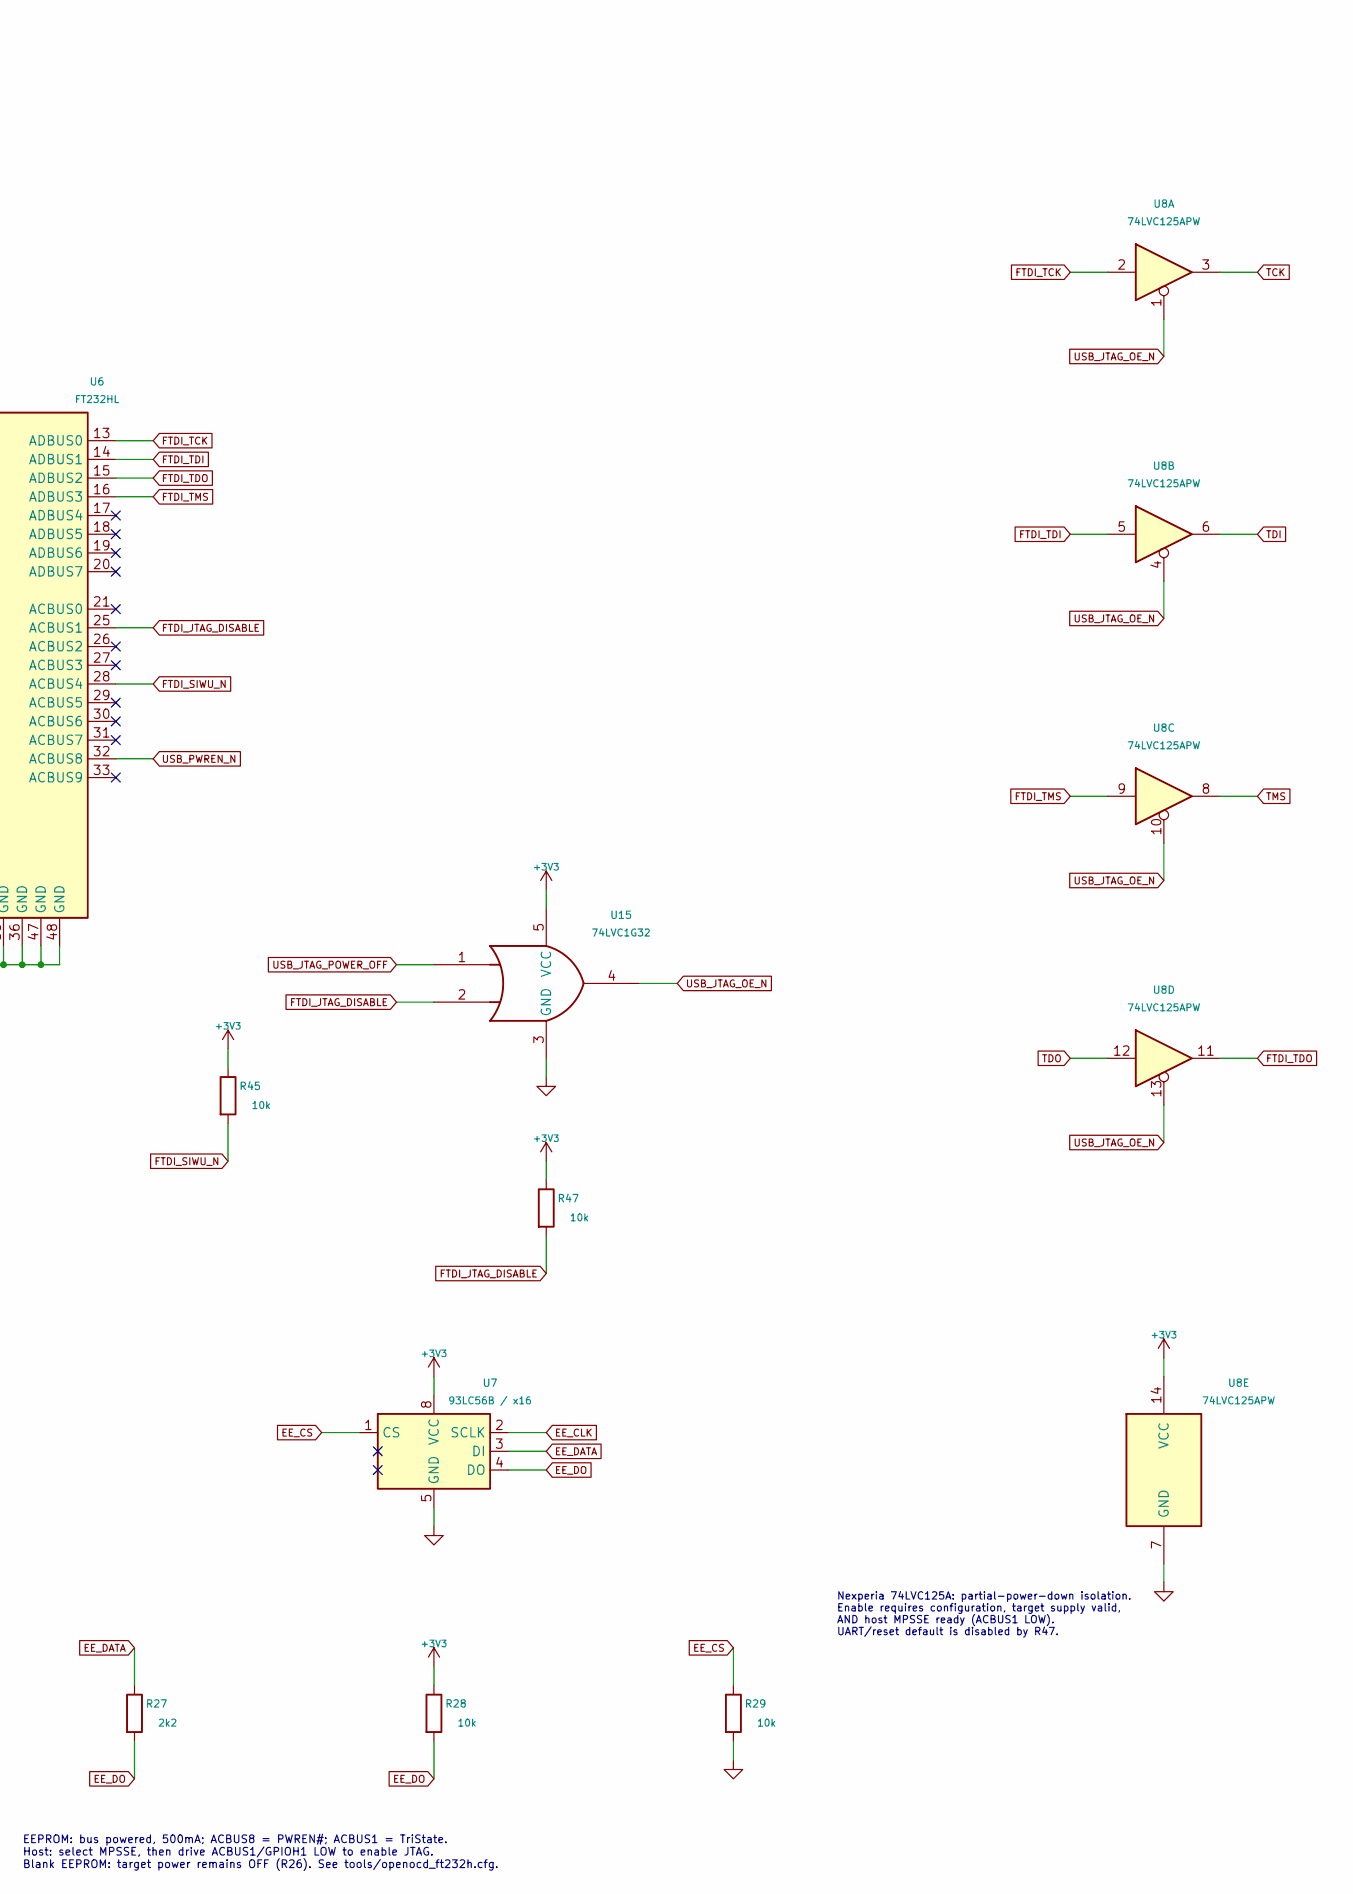
[picture p39: schematic usb_programming.kicad_sch, part in row 1, column 2]

Parts:
C9, C10: 27p; C_0805_2012Metric
D4: USBLC6-2SC6; SOT-23-6
J2: ATF15xx JTAG - THT; IDC-Header_2x05_P2.54mm_Vertical; not fitted
J6: USB_B_PROGRAM; USB_B_Lumberg_2411_02_Horizontal
R24: 12k 1%; R_0805_2012Metric
R25, R26, R28, R29, R45, R47: 10k; R_0805_2012Metric
R27: 2k2; R_0805_2012Metric
U6: FT232HL; LQFP-48_7x7mm_P0.5mm
U7: 93LC56B / x16; SOIC-8_3.9x4.9mm_P1.27mm
U8: 74LVC125APW; TSSOP-14_4.4x5mm_P0.65mm
U15: 74LVC1G32; SOT-23-5
Y1: 12MHz / CL=18pF / 30ppm; Crystal_HC49-U_Vertical

Connections:
+1V8: U6.38 (VCCCORE)
+1V8_A: U6.37 (VCCA)
+3V3: R25.1, R26.1, R28.1, R45.1, R47.1, U6.3 (VPHY), U6.8 (VPLL), U6.12 (VCCIO), U6.24 (VCCIO), U6.39 (VCCD), U6.46 (VCCIO), U7.8 (VCC), U8.14 (VCC), U15.5 (VCC)
+5V: J2.4 (VCCT)
EE_CLK: U6.44 (EECLK), U7.2 (SCLK)
EE_CS: R29.1, U6.45 (EECS), U7.1 (CS)
EE_DATA: R27.1, U6.43 (EEDATA), U7.3 (DI)
EE_DO: R27.2, R28.2, U7.4 (DO)
FTDI_JTAG_DISABLE: R47.2, U6.25 (ACBUS1), U15.2
FTDI_OSCI: C9.1, U6.1 (XCSI), Y1.1
FTDI_OSCO: C10.1, U6.2 (XCSO), Y1.2
FTDI_REF: R24.1, U6.5 (REF)
FTDI_RESET_N: R25.2, U6.34 (~RESET)
FTDI_SIWU_N: R45.2, U6.28 (ACBUS4)
FTDI_TCK: U6.13 (ADBUS0), U8.2
FTDI_TDI: U6.14 (ADBUS1), U8.5
FTDI_TDO: U6.15 (ADBUS2), U8.11
FTDI_TMS: U6.16 (ADBUS3), U8.9
GND: C9.2, C10.2, D4.2 (GND), J2.2 (GND), J2.10 (GND), J6.4 (GND), J6.SH (Shield), R24.2, R29.2, U6.4 (AGND), U6.9 (AGND), U6.10 (GND), U6.11 (GND), U6.22 (GND), U6.23 (GND), U6.35 (GND), U6.36 (GND), U6.41 (AGND), U6.42 (TEST), U6.47 (GND), U6.48 (GND), U7.5 (GND), U8.7 (GND), U15.3 (GND)
TCK: J2.1 (TCK), U8.3
TDI: J2.9 (TDI), U8.6
TDO: J2.3 (TDO), U8.12
TMS: J2.5 (TMS), U8.8
USB_DM: D4.1 (I/O1), D4.6 (I/O1), J6.2 (D-), U6.6 (DM)
USB_DP: D4.3 (I/O2), D4.4 (I/O2), J6.3 (D+), U6.7 (DP)
USB_JTAG_OE_N: U8.1, U8.4, U8.10, U8.13, U15.4
USB_JTAG_POWER_OFF: U15.1
USB_PWREN_N: R26.2, U6.32 (ACBUS8)
VBUS: D4.5 (VBUS), J6.1 (VBUS), U6.40 (VREGIN)

Notes on the sheet:
ORDER OPTIONS: USB = FT232H circuit, no J2; HEADER = J2, omit USB-only parts
Keyed 2x5 IDC, 2.54mm, through-hole. Pin 4 = target supply OUT to cable. J2 only in HEADER assembly; no FTDI fitted.
USB 2.0 device connector; shield bonded to board GND. Route D+/D- together as a 90-ohm differential pair. D4 provides low-capacitance USB ESD protection.
EEPROM: bus powered, 500mA; ACBUS8 = PWREN#; ACBUS1 = TriState. Host: select MPSSE, then drive ACBUS1/GPIOH1 LOW to enable JTAG. Blank EEPROM: target power remains OFF (R26). See tools/openocd_ft232h.cfg.
Nexperia 74LVC125A: partial-power-down isolation. Enable requires configuration, target supply valid, AND host MPSSE ready (ACBUS1 LOW). UART/reset default is disabled by R47.
